josedaparte/TESIS/doumentos_PROPIOS/Diseño_PWM/Imagenes_documento/amp-error-coneccion.PNG

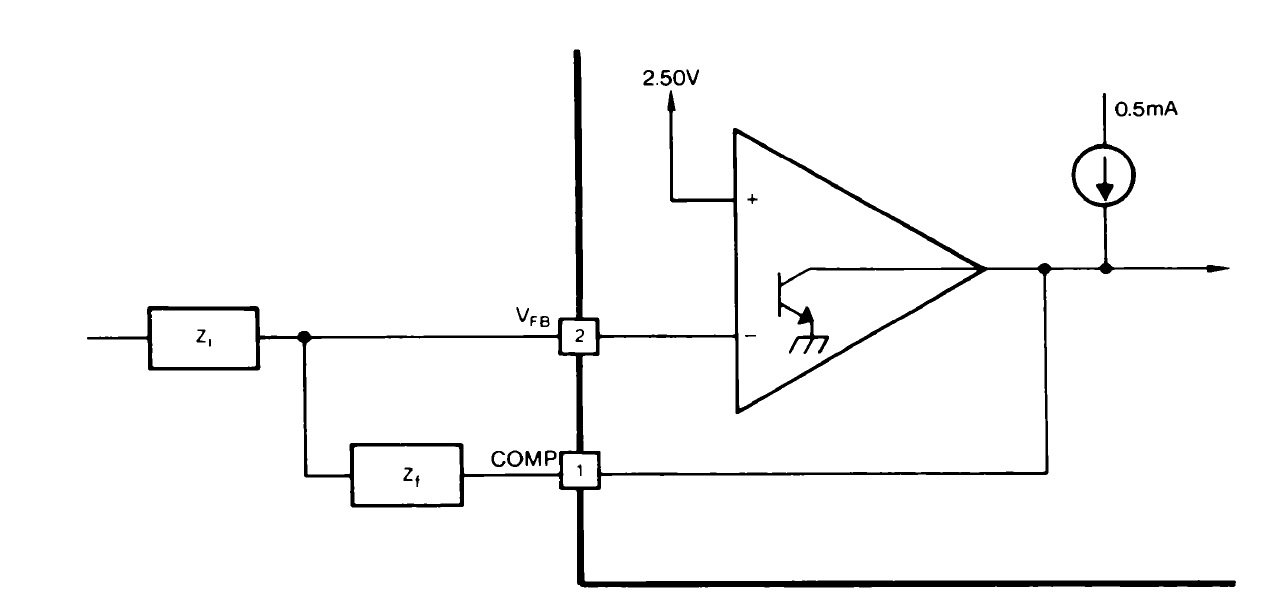
doumentos_PROPIOS/Diseño_PWM/Imagenes_documento/amp-error-coneccion.PNG
