josedaparte/TESIS/doumentos_PROPIOS/Diseño_PWM/Imagenes_documento/Amplificador-error.PNG

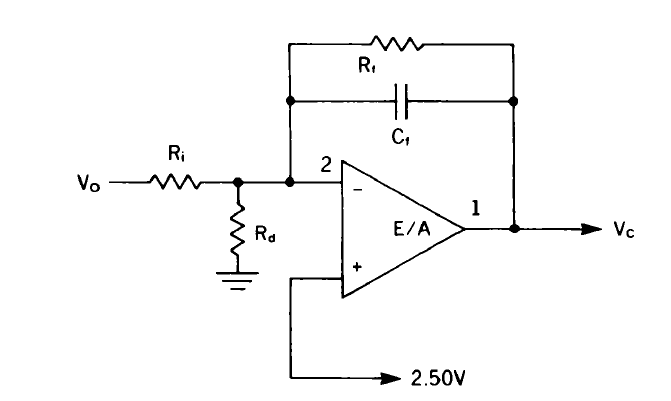
doumentos_PROPIOS/Diseño_PWM/Imagenes_documento/Amplificador-error.PNG
