josedaparte/TESIS/doumentos_PROPIOS/Diseño_PWM/Imagenes_documento/circuito_oscilador.PNG

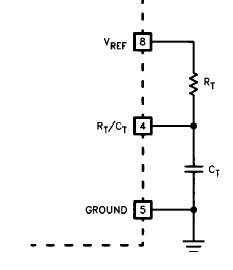
doumentos_PROPIOS/Diseño_PWM/Imagenes_documento/circuito_oscilador.PNG
