josedaparte/TESIS/doumentos_PROPIOS/Diseño_PWM/Imagenes_documento/Esquema_UC3842.PNG

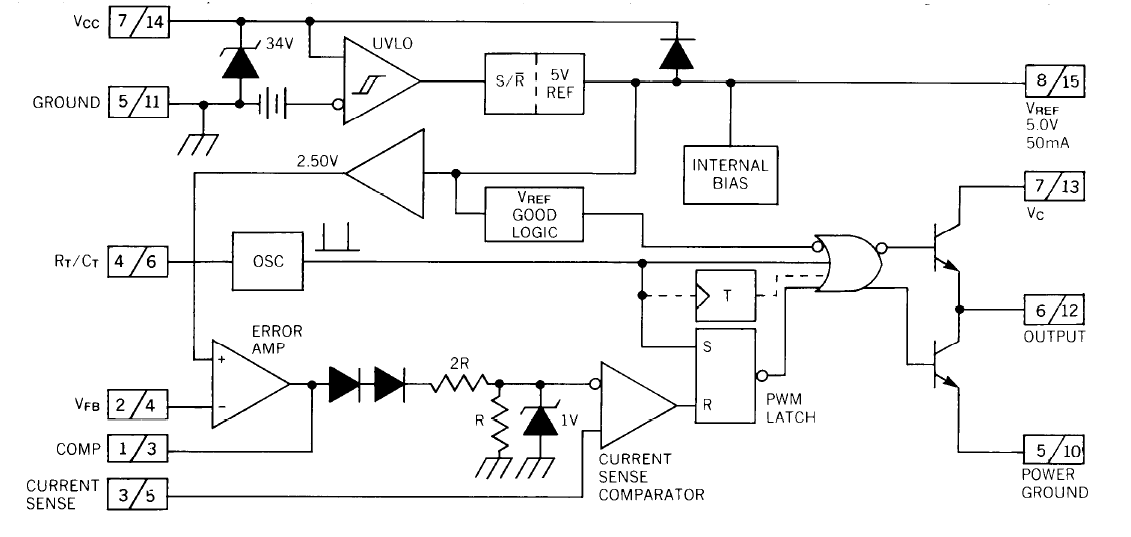
doumentos_PROPIOS/Diseño_PWM/Imagenes_documento/Esquema_UC3842.PNG
