josedaparte/TESIS/doumentos_PROPIOS/Diseño_PWM/Imagenes_documento/IC_selection.PNG

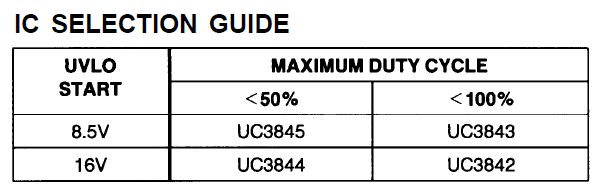
doumentos_PROPIOS/Diseño_PWM/Imagenes_documento/IC_selection.PNG
