josedaparte/TESIS/Scripts_MATLAB/Componentes a utilizar.txt

Mosfet 
Ipk = 3.01A
Irms = 1.8A	--> MOSFETFQP5N60C_600V_4A5

Diodo salida
IPk = 2.72A
Iavg = 1.2A
Vinv = 515V	-->

Rsensora corriente
Rcs=0.33Ohm
Irms = 1.8A				

Cin = 138uF	--> Valor cercano

Cout= 51uF	--> Valor cercano	

Lp=940uH

transistor regulador para el opto y tl 2n5400
