josedaparte/TESIS/Documentos utiles/Diseño_por_texas_100V_1200mA.pdf

## WEBENCH ® Design Report

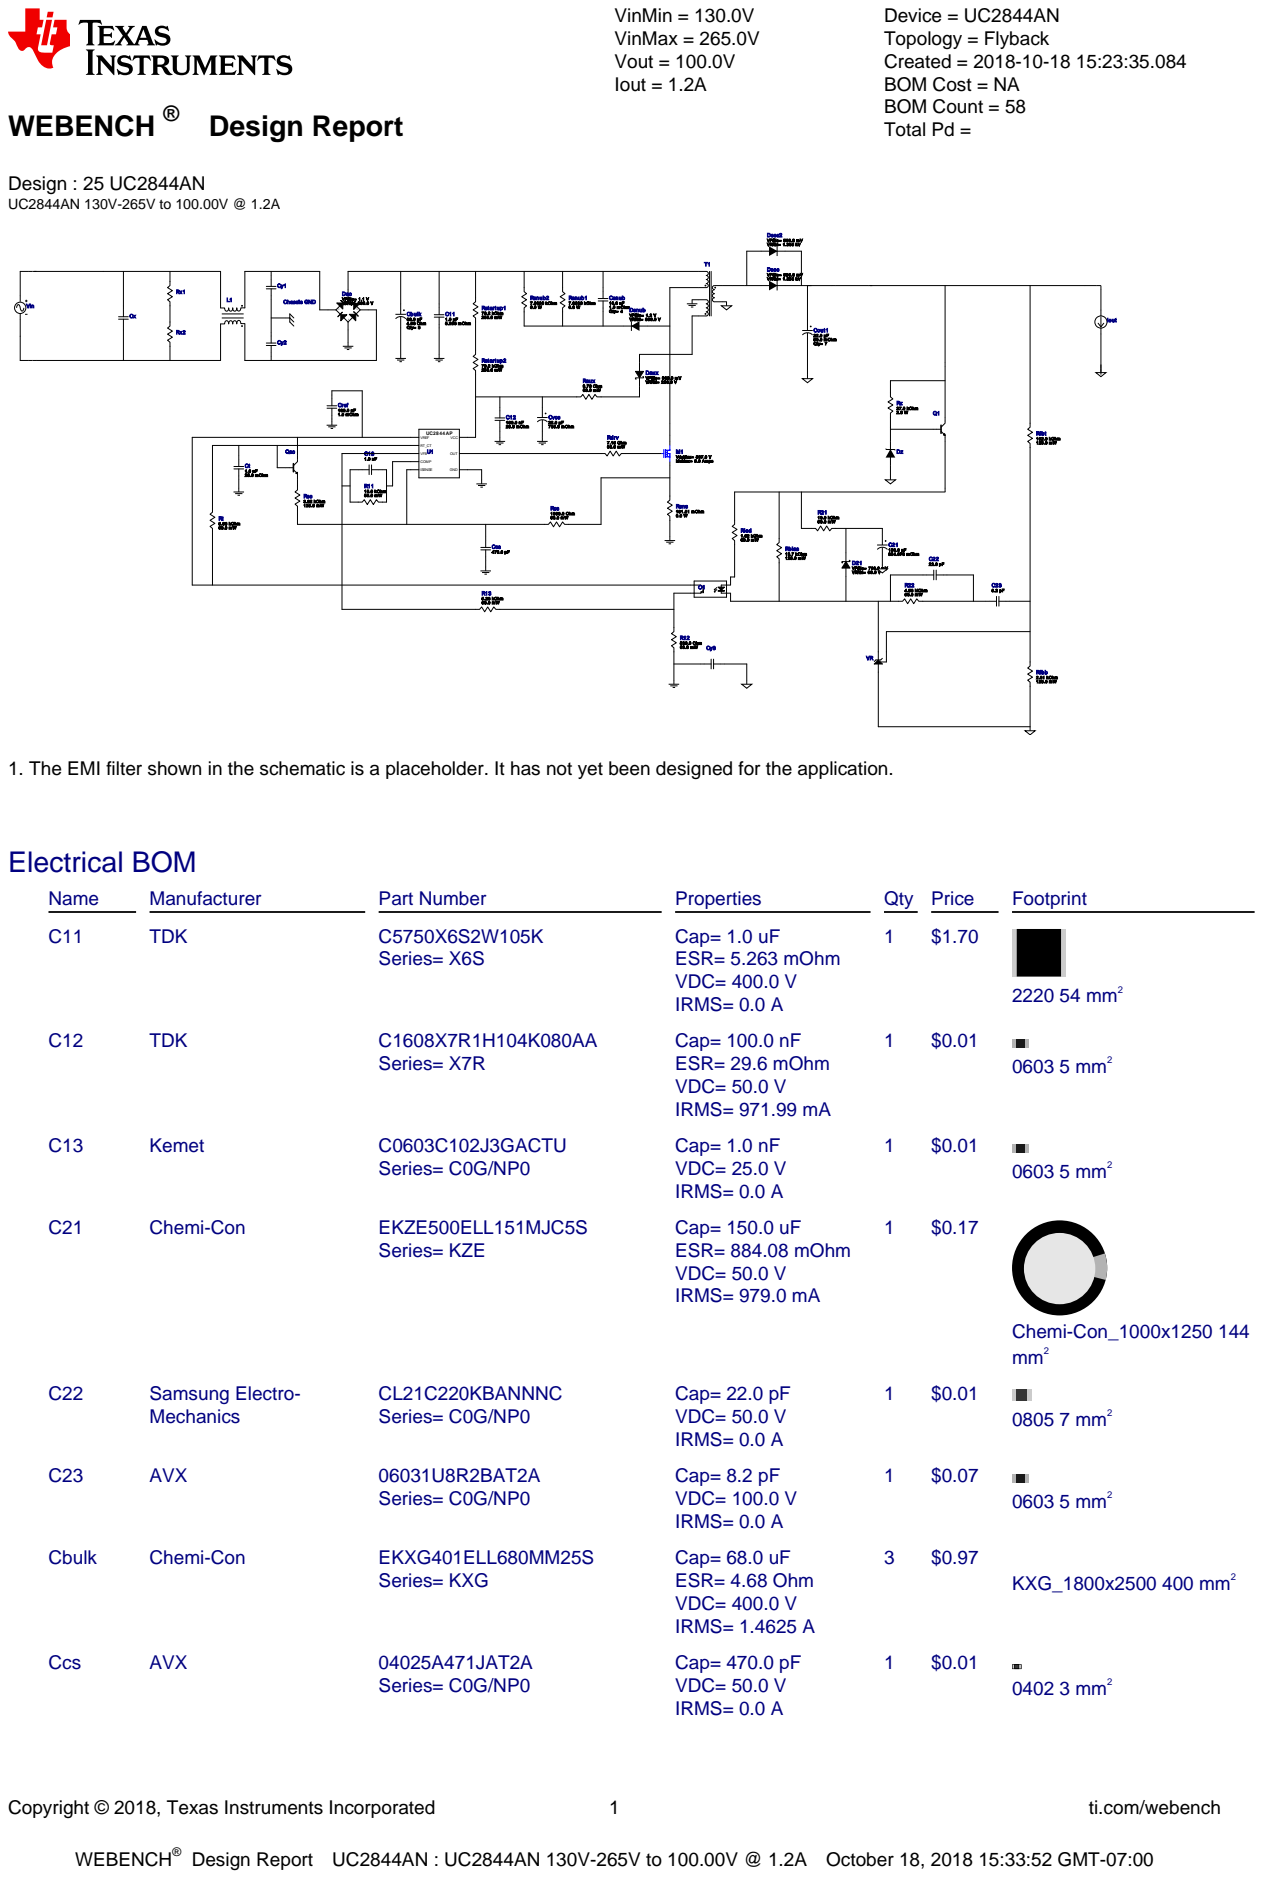
[picture p31: page 1]

Dsec VF@Io= 500.0 mV

Daux VF@Io= 900.0 mV

1. The EMI filter shown in the schematic is a placeholder. It has not yet been designed for the application.

Design Report UC2844AN : UC2844AN 130V-265V to 100.00V @ 1.2A October 18, 2018 15:33:52 GMT-07:00

Design

Copyright © 2018, Texas Instruments Incorporated | 2 | ti.com/webench
Name | Manufacturer | Part Number | Properties | Qty Price | Footprint
Cout1 | Rubycon | 400PK22MEFC12_5X20 (http://www.rubycon.co.jp/en/catalog/e%5Fpdfs/aluminum/e%5Fpk.pdf) Series= PK | Cap= 22.0 uF ESR= 50.0 mOhm VDC= 400.0 V IRMS= 200.0 mA
7 | $0.40

CAPPR7 144 mm²
Cref | MuRata | GRM155R61C104KA88D (http://search.murata.co.jp/Ceramy/PnsearchViewAction.do) Series= X5R

Cap= 100.0 nF
ESR= 1.0 mOhm
VDC= 16.0 V
IRMS= 0.0 A

1 $0.01
0402 3 mm²
Csnub | MuRata | GRM21BR72E103KW03L (http://search.murata.co.jp/Ceramy/PnsearchViewAction.do) Series= X7R

Cap= 10.0 nF
ESR= 1.0 mOhm
VDC= 250.0 V
IRMS= 0.0 A

4 $0.04
0805 7 mm²
Ct | Kemet | C0805C102J1GACTU (http://capacitoredge.kemet.com/capedge2/DataSheet/Datasheet%2DC0805C102J1GACTU.pdf?pn%3DC0805C102J1GACTU) Series= C0G/NP0

Cap= 1.0 nF
ESR= 25.0 mOhm
VDC= 100.0 V
IRMS= 1.71 A

1 $0.10
0805 7 mm²
Cvcc | Nichicon | UUD1V220MCL1GS (http://products.nichicon.co.jp/en/pdf/XJA043/e%2Dud.pdf) Series= uD | Cap= 22.0 uF ESR= 760.0 mOhm VDC= 35.0 V IRMS= 150.0 mA
1 | $0.10

SM_RADIAL_5MM 58 mm²

D21 | Fairchild Semiconductor SS26FL | VF@Io= 700.0 mV
| | | VRRM= 60.0 V
1 | $0.10
SOD-123F 12 mm²
Dac | Diodes Inc. | DF1506S-T (http://www.diodes.com/datasheets/ds17002.pdf) | VF@Io= 1.1 V VRRM= 600.0 V
1 | $0.23

DF-S 99 mm²
Daux | SMC Diode Solutions | SK220ATR (http://www.smc%2Ddiodes.com/propdf/SK220A%20N0942%20REV.A.pdf) | VF@Io= 900.0 mV VRRM= 200.0 V | 1 | $0.04

SMA 37 mm²
Dsec | CUSTOM | CUSTOM | VF@Io= 500.0 mV VRRM= 1.355 kV | 1 | NA
CUSTOM 0 mm²
Dsec2 | CUSTOM | CUSTOM | VF@Io= 500.0 mV VRRM= 1.355 kV | 1 | NA
CUSTOM 0 mm²
Dsnub | Microsemi | UFS180JE3/TR13 | VF@Io= 1.2 V VRRM= 800.0 V | 1 | $0.71

DO-214BA 42 mm²
Dz | Diodes Inc. | MMSZ5250B-7-F (http://www.diodes.com/datasheets/ds18010.pdf) | Zener | 1 | $0.04
SOD-123 13 mm²
M1 | NA | IdealFET | VdsMax= 597.0 V IdsMax= 5.0 Amps | 1 | NA
NA 0 mm²
O1 | Fairchild Semiconductor FOD817A | Optocoupler | 1 | $0.13

DIP-4 71 mm²
Q1 | Nexperia | MMBTA42 (http://www.nxp.com/documents/data%5Fsheet/MMBTA42.pdf) | Bipolar Transistor | 1 | $0.05

SOT-23 14 mm²
Qsc | STMicroelectronics | 2N2222A (http://www.st.com/web/en/resource/technical/document/datasheet/CD00003223.pdf) | Bipolar Transistor | 1 | $1.02

TO-18 57 mm²
R11 | Yageo | RC0201FR-0710KL (http://www.yageo.com/exep/pages/download/literatures/PYu%2DR%5FMarking%5F2.pdf) Series= ? | Res= 10.0 kOhm Power= 50.0 mW Tolerance= 1.0% | 1 | $0.01
0201 2 mm²
R12 | Vishay-Dale | CRCW0402536RFKED (http://www.vishay.com/docs/20035/dcrcwe3.pdf) Series= CRCW..e3 | Res= 536.0 Ohm Power= 63.0 mW Tolerance= 1.0% | 1 | $0.01
0402 3 mm²
R13 | Vishay-Dale | CRCW04025K23FKED (http://www.vishay.com/docs/20035/dcrcwe3.pdf) Series= CRCW..e3 | Res= 5.23 kOhm Power= 63.0 mW Tolerance= 1.0% | 1 | $0.01
0402 3 mm²

Copyright © 2018, Texas Instruments Incorporated | 3 | ti.com/webench
Name | Manufacturer | Part Number | Properties | Qty Price | Footprint
R21 | Yageo | RC0201FR-0710KL (http://www.yageo.com/exep/pages/download/literatures/PYu%2DR%5FMarking%5F2.pdf) Series= ? | Res= 10.0 kOhm Power= 50.0 mW Tolerance= 1.0%
1 | $0.01
| | | | | 0201 2 mm²
R22 | Vishay-Dale | CRCW04024M53FKED (http://www.vishay.com/docs/20035/dcrcwe3.pdf) Series= CRCW..e3 | Res= 4.53 MOhm Power= 63.0 mW Tolerance= 1.0%
1 | $0.01
| | | | | 0402 3 mm²
Raux | Vishay-Dale | CRCW04029R76FKED (http://www.vishay.com/docs/20035/dcrcwe3.pdf) Series= CRCW..e3 | Res= 9.76 Ohm Power= 63.0 mW Tolerance= 1.0%
1 | $0.01
| | | | | 0402 3 mm²
Rbias | Panasonic | ERJ-6ENF1372V Series= ERJ-6E | Res= 13.7 kOhm Power= 125.0 mW Tolerance= 1.0%
1 | $0.01
| | | | | 0805 7 mm²
Rcs | Vishay-Dale | CRCW04021K00FKED (http://www.vishay.com/docs/20035/dcrcwe3.pdf) Series= CRCW..e3 | Res= 1000.0 Ohm Power= 63.0 mW Tolerance= 1.0%
1 | $0.01
| | | | | 0402 3 mm²
Rdrv | Vishay-Dale | CRCW04027R15FKED (http://www.vishay.com/docs/20035/dcrcwe3.pdf) Series= CRCW..e3 | Res= 7.15 Ohm Power= 63.0 mW Tolerance= 1.0%
1 | $0.01
| | | | | 0402 3 mm²
Rfbb | Panasonic | ERJ-6ENF2611V Series= ERJ-6E | Res= 2.61 kOhm Power= 125.0 mW Tolerance= 1.0%
1 | $0.01
| | | | | 0805 7 mm²
Rfbt | Vishay-Dale | CRCW0805102KFKEA (http://www.vishay.com/docs/20035/dcrcwe3.pdf) Series= CRCW..e3 | Res= 102.0 kOhm Power= 125.0 mW Tolerance= 1.0%
1 | $0.01
| | | | | 0805 7 mm²
Rled | Vishay-Dale | CRCW04021K62FKED (http://www.vishay.com/docs/20035/dcrcwe3.pdf) Series= CRCW..e3 | Res= 1.62 kOhm Power= 63.0 mW Tolerance= 1.0%
1 | $0.01
| | | | | 0402 3 mm²
Rsc | Vishay-Dale | CRCW08053K92FKEA (http://www.vishay.com/docs/20035/dcrcwe3.pdf) Series= CRCW..e3 | Res= 3.92 kOhm Power= 125.0 mW Tolerance= 1.0%
1 | $0.01
| | | | | 0805 7 mm²
Rsns | CUSTOM | CUSTOM Series= ? | Res= 181.51 mOhm Power= 0.0 W Tolerance= 0.0%
1 | NA
| | | | | CUSTOM 0 mm²
Rsnub1 | CUSTOM | CUSTOM Series= ? | Res= 7.0636 kOhm Power= 0.0 W Tolerance= 0.0%
1 | NA
| | | | | CUSTOM 0 mm²
Rsnub2 | CUSTOM | CUSTOM Series= ? | Res= 7.0636 kOhm Power= 0.0 W Tolerance= 0.0%
1 | NA
| | | | | CUSTOM 0 mm²
Rstartup1 Vishay-Dale | CRCW120673K2FKEA (http://www.vishay.com/docs/20035/dcrcwe3.pdf)
| | Series= CRCW..e3 | Res= 73.2 kOhm Power= 250.0 mW Tolerance= 1.0%
1 | $0.01
| | | | | 1206 11 mm²
Rstartup2 Vishay-Dale | CRCW120673K2FKEA (http://www.vishay.com/docs/20035/dcrcwe3.pdf)
| | Series= CRCW..e3 | Res= 73.2 kOhm Power= 250.0 mW Tolerance= 1.0%
1 | $0.01
| | | | | 1206 11 mm²
Rt | Vishay-Dale | CRCW04028K66FKED (http://www.vishay.com/docs/20035/dcrcwe3.pdf) Series= CRCW..e3 | Res= 8.66 kOhm Power= 63.0 mW Tolerance= 1.0%
1 | $0.01
| | | | | 0402 3 mm²
Rz | Stackpole Electronics Inc RSMF2JT27K0 (http://www.seielect.com/Catalog/SEI%2DRSF%5FRSMF.pdf)
| | Series= ? | Res= 27.0 kOhm Power= 2.0 W Tolerance= 5.0%
1 | $0.02
| | | | | RSMF2 148 mm²
T1 | Core=TDK , CoilFormer=TDK | Core=B66423G0000X197 , CoilFormer=B66424W1012D001 | Lp= 203.0 µH Turns Ratio(Nas)= 9:58 Turns Ratio(Nps)= 49:58 Npri= 49.0 Naux= 9.0 Nsec= 58.0
1 | $1.25
| | | | | TDK_B66305 930 mm²

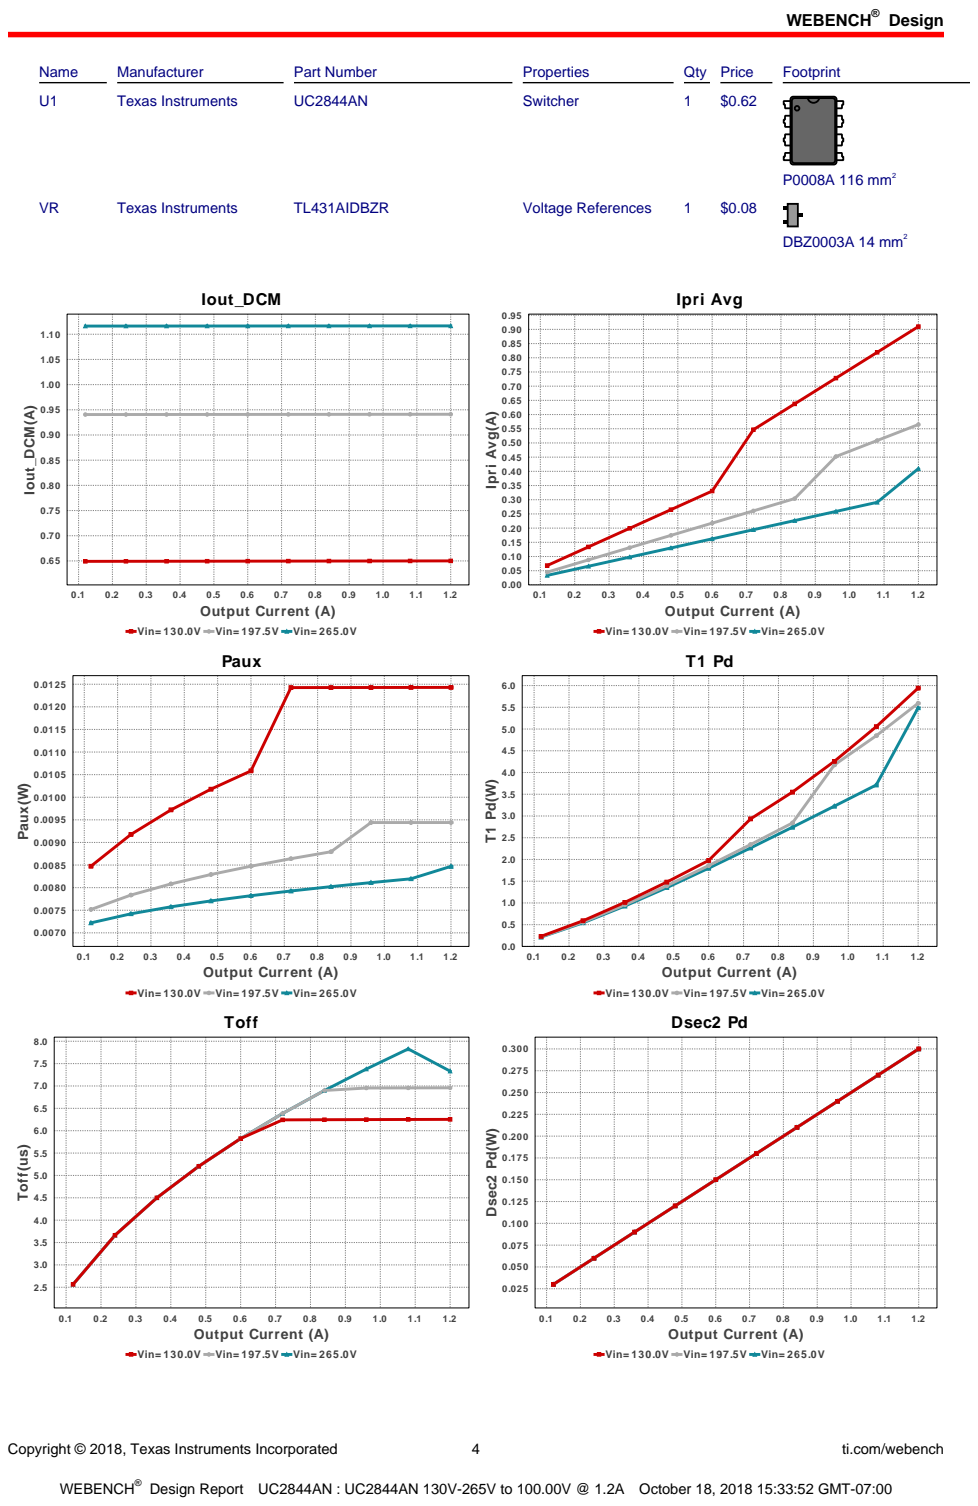
[picture p32: page 4]
Copyright © 2018, Texas Instruments Incorporated; ti.com/webench; Name; Manufacturer; Part Number; Properties; Qty Price; Footprint; Texas Instruments; Switcher; P0008A 116 mm²; TL431AIDBZR; Voltage References; DBZ0003A 14 mm²; Iout_DCM; 1.2 Output Current (A); Iout_DCM(A); Ipri Avg; Ipri Avg(A); Paux; Paux(W); Toff; Toff(us); Dsec2 Pd; Dsec2 Pd(W)

Vin= 130.0V Vin= 197.5V Vin= 265.0V

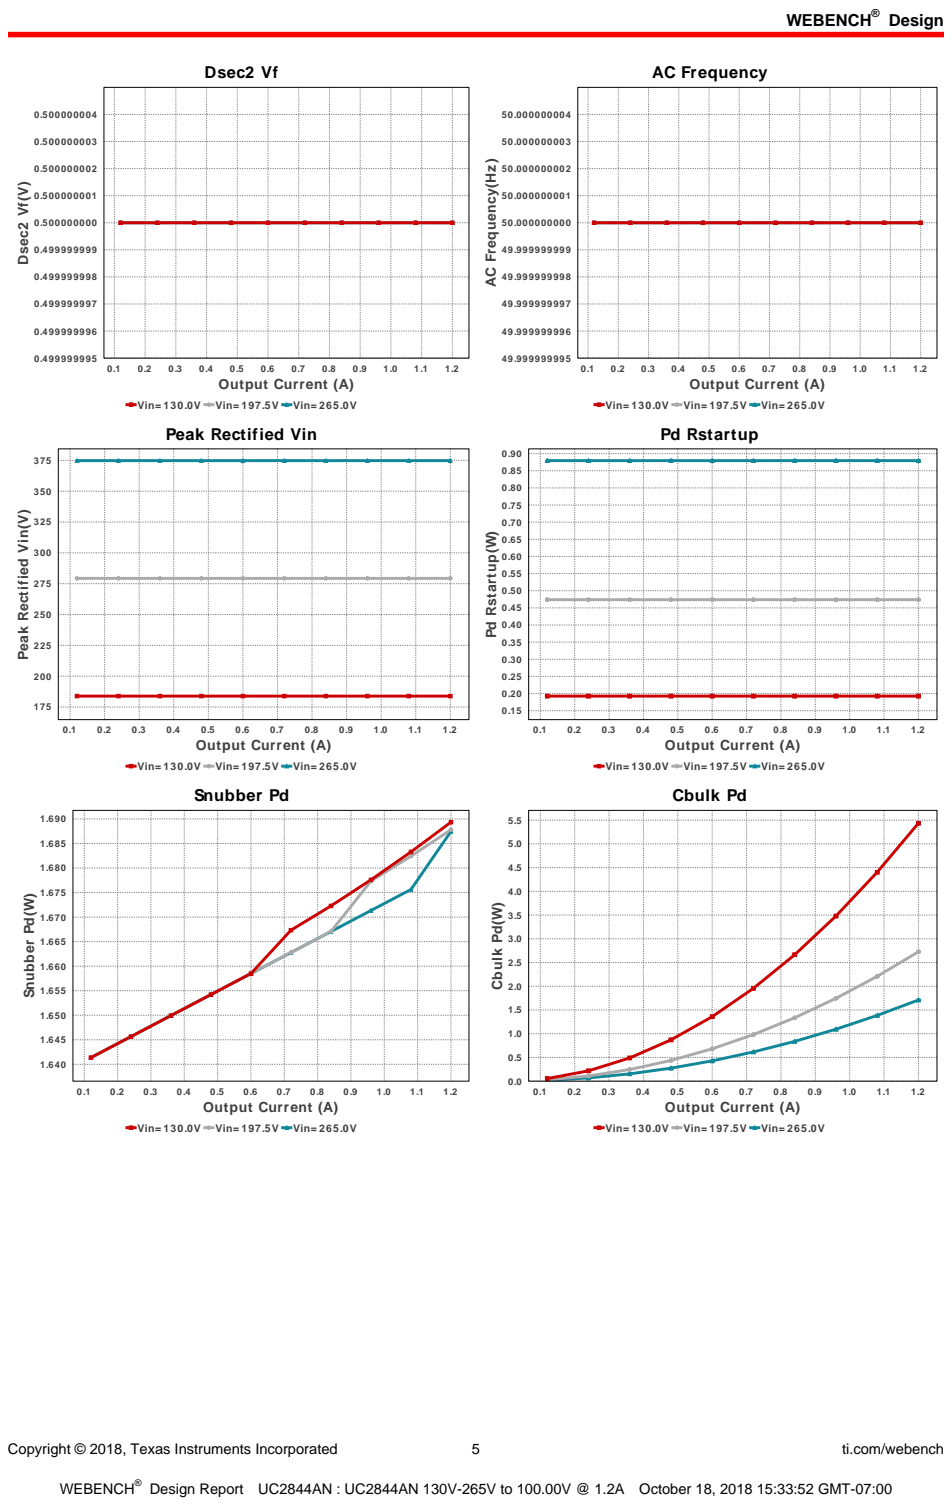
[picture p33: page 5]
Copyright © 2018, Texas Instruments Incorporated; ti.com/webench; Dsec2 Vf; 1.2 Output Current (A); Dsec2 Vf(V); AC Frequency; Pd Rstartup(W); Snubber Pd(W); Cbulk Pd; Cbulk Pd(W)

AC Frequency(Hz)

Vin= 130.0V Vin= 197.5V Vin= 265.0V
Peak Rectified Vin

Pd Rstartup

Peak Rectified Vin(V)

Snubber Pd

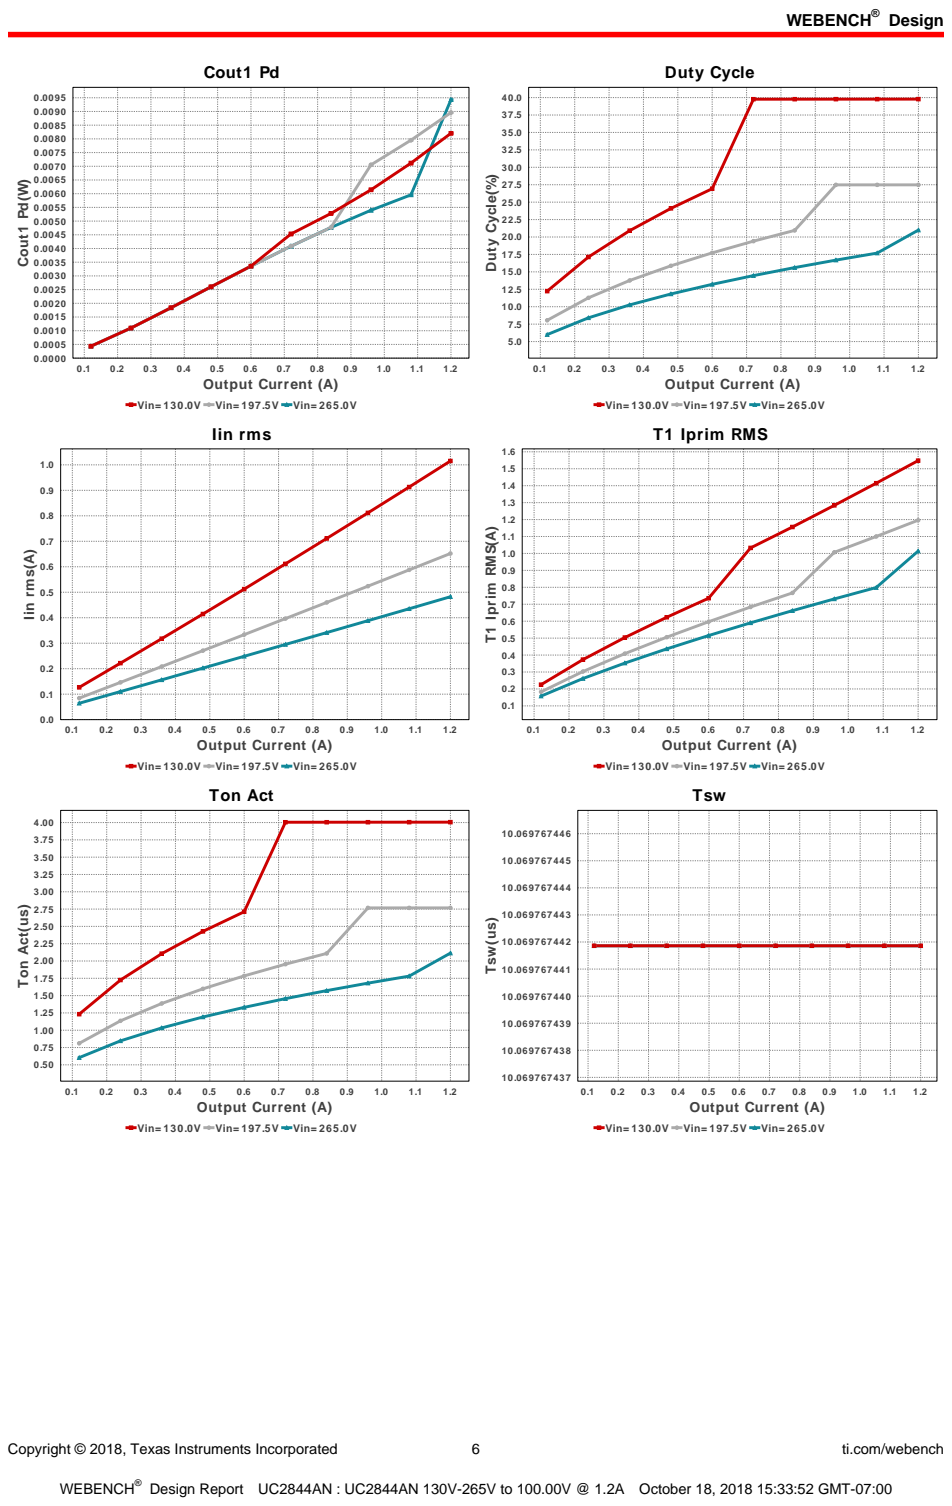
[picture p34: page 6]
Copyright © 2018, Texas Instruments Incorporated; ti.com/webench; Cout1 Pd; 1.2 Output Current (A); Cout1 Pd(W); Duty Cycle; Duty Cycle(%); Iin rms; Iin rms(A); T1 Iprim RMS(A); Ton Act; Tsw; Tsw(us)

Vin= 130.0V Vin= 197.5V Vin= 265.0V

T1 Iprim RMS

Ton Act(us)

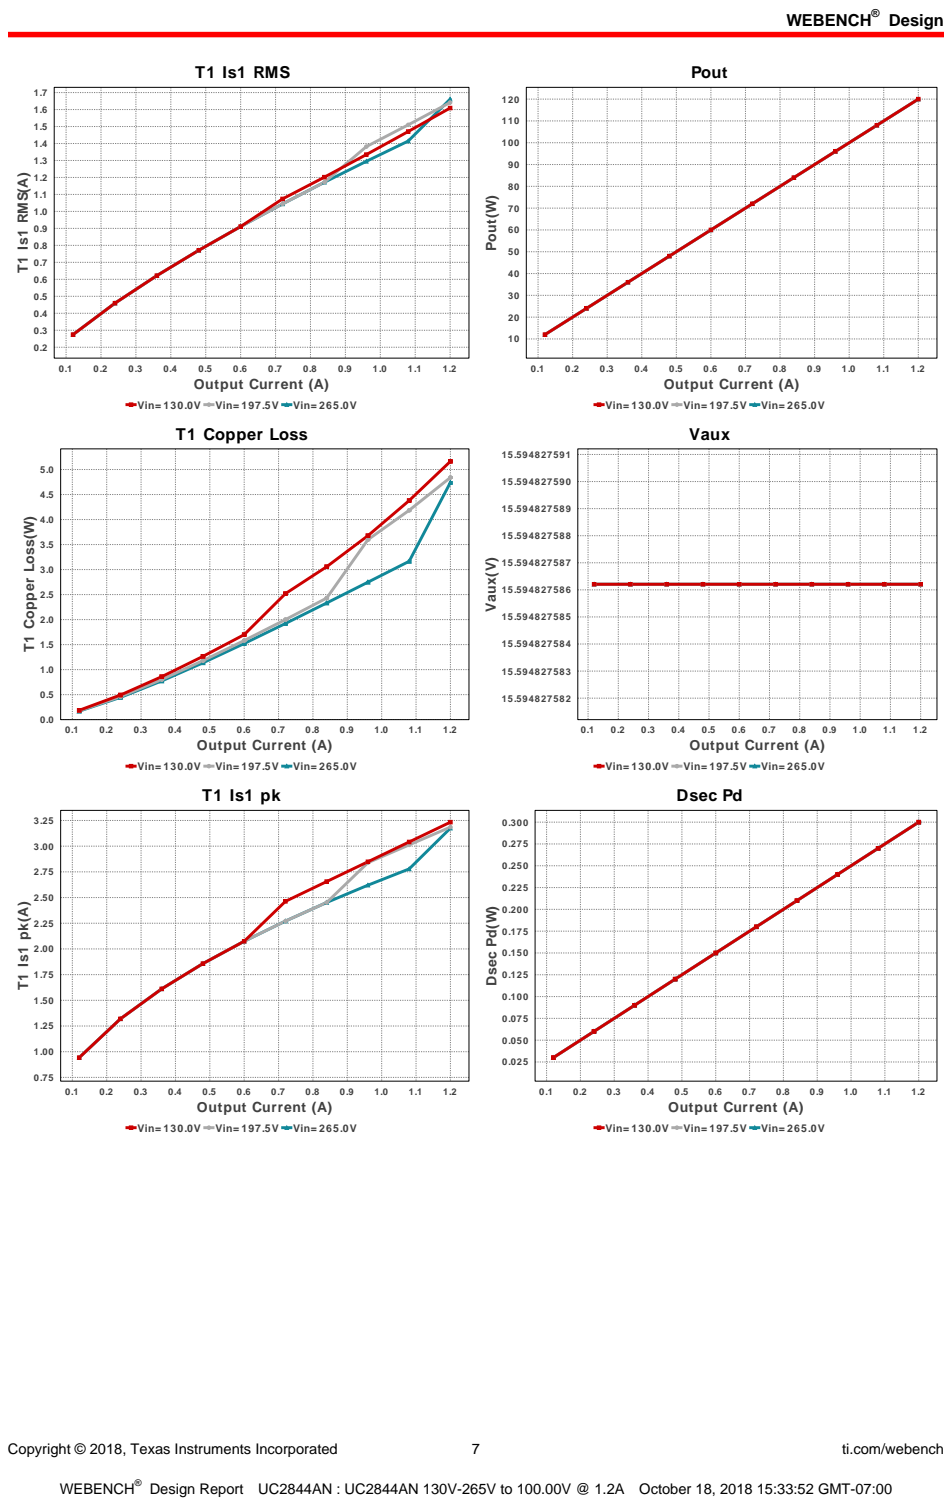
[picture p35: page 7]
Copyright © 2018, Texas Instruments Incorporated; ti.com/webench; T1 Is1 RMS; 1.2 Output Current (A); T1 Is1 RMS(A); Pout; Pout(W); T1 Copper Loss(W); Vaux; Vaux(V); Dsec Pd; Dsec Pd(W)

Vin= 130.0V Vin= 197.5V Vin= 265.0V
T1 Copper Loss

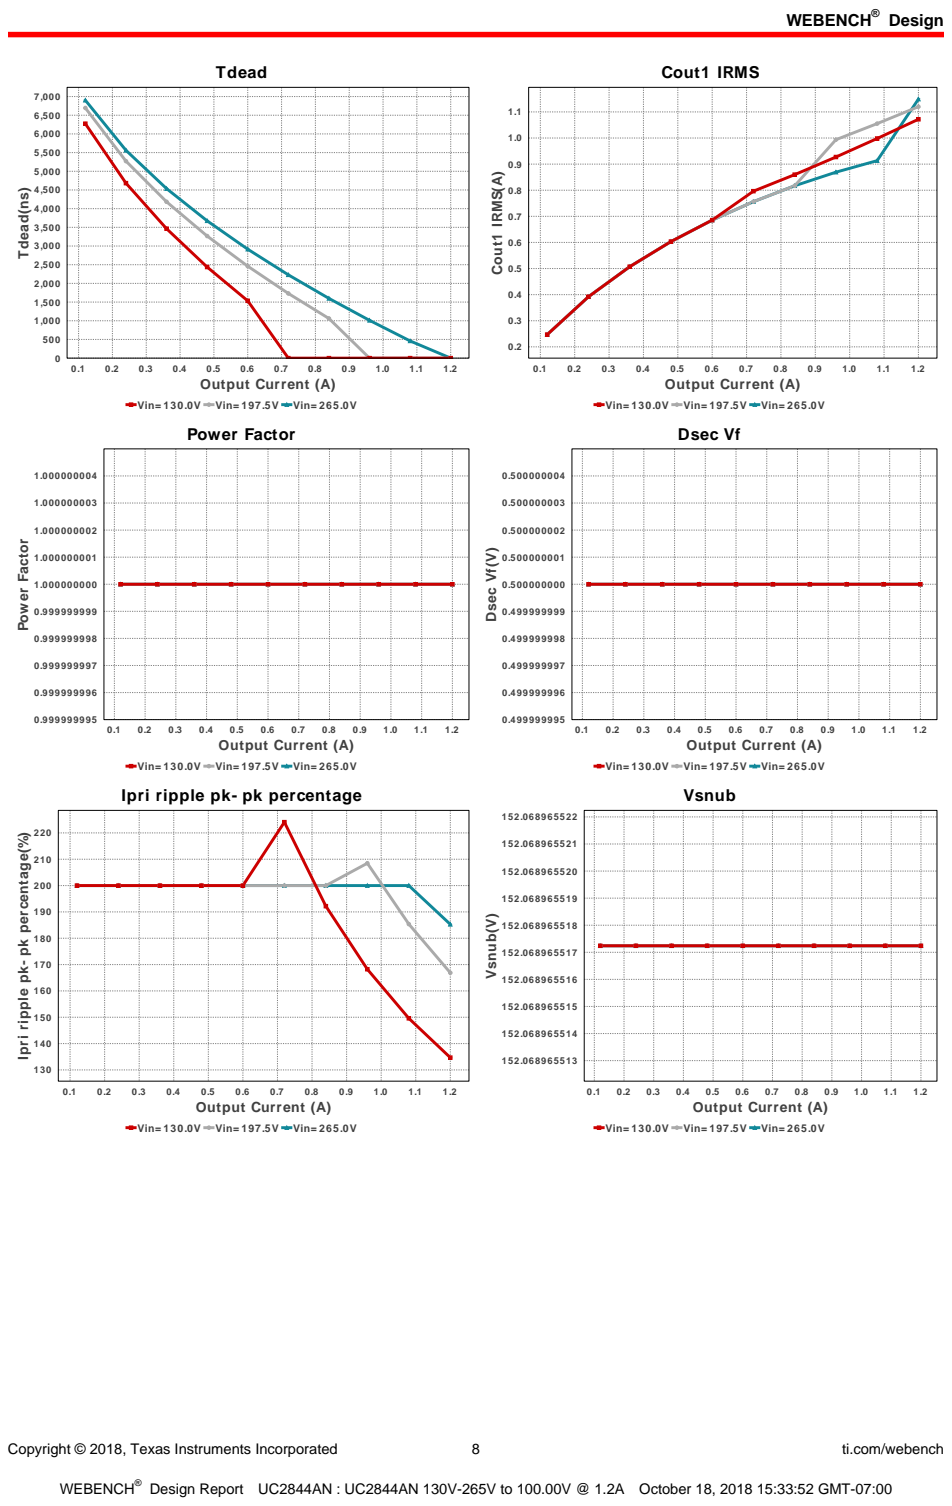
[picture p36: page 8]
Copyright © 2018, Texas Instruments Incorporated; ti.com/webench; Tdead; 1.2 Output Current (A); Tdead(ns); Cout1 IRMS; Cout1 IRMS(A); Power Factor; Dsec Vf; Dsec Vf(V); Vsnub; Vsnub(V)

Vin= 130.0V Vin= 197.5V Vin= 265.0V
Power Factor

Ipri ripple pk- pk percentage

Ipri ripple pk- pk percentage(%)

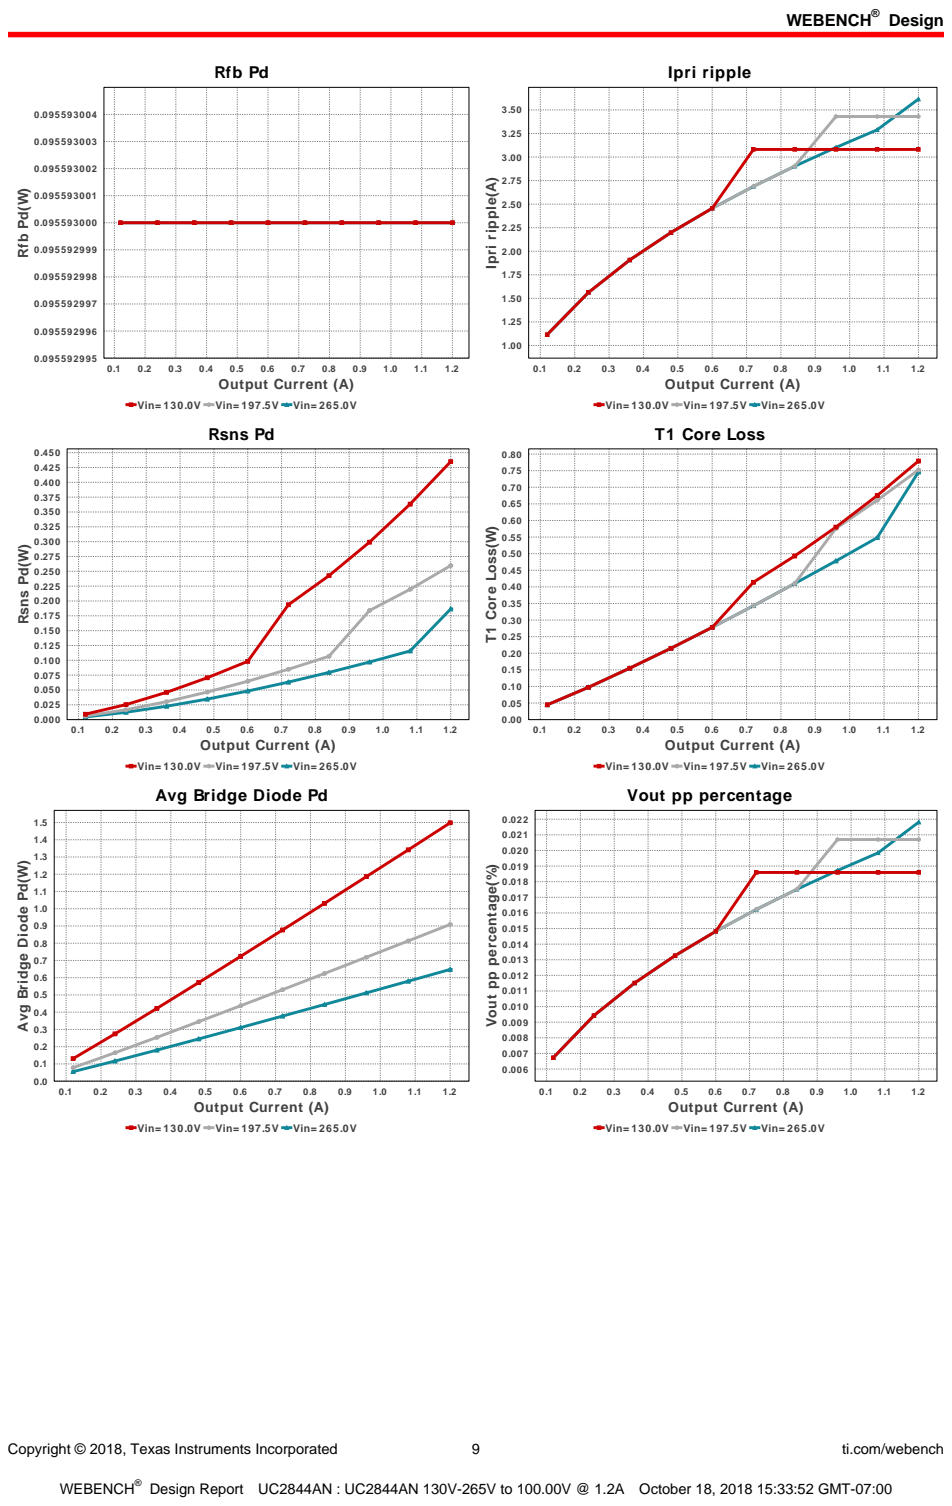
[picture p37: page 9]
Copyright © 2018, Texas Instruments Incorporated; ti.com/webench; Rfb Pd; 1.2 Output Current (A); Rfb Pd(W); Ipri ripple; Ipri ripple(A); Rsns Pd; Rsns Pd(W); T1 Core Loss(W)

Vin= 130.0V Vin= 197.5V Vin= 265.0V

T1 Core Loss

Avg Bridge Diode Pd

Vout pp percentage

Avg Bridge Diode Pd(W)

Vout pp percentage(%)

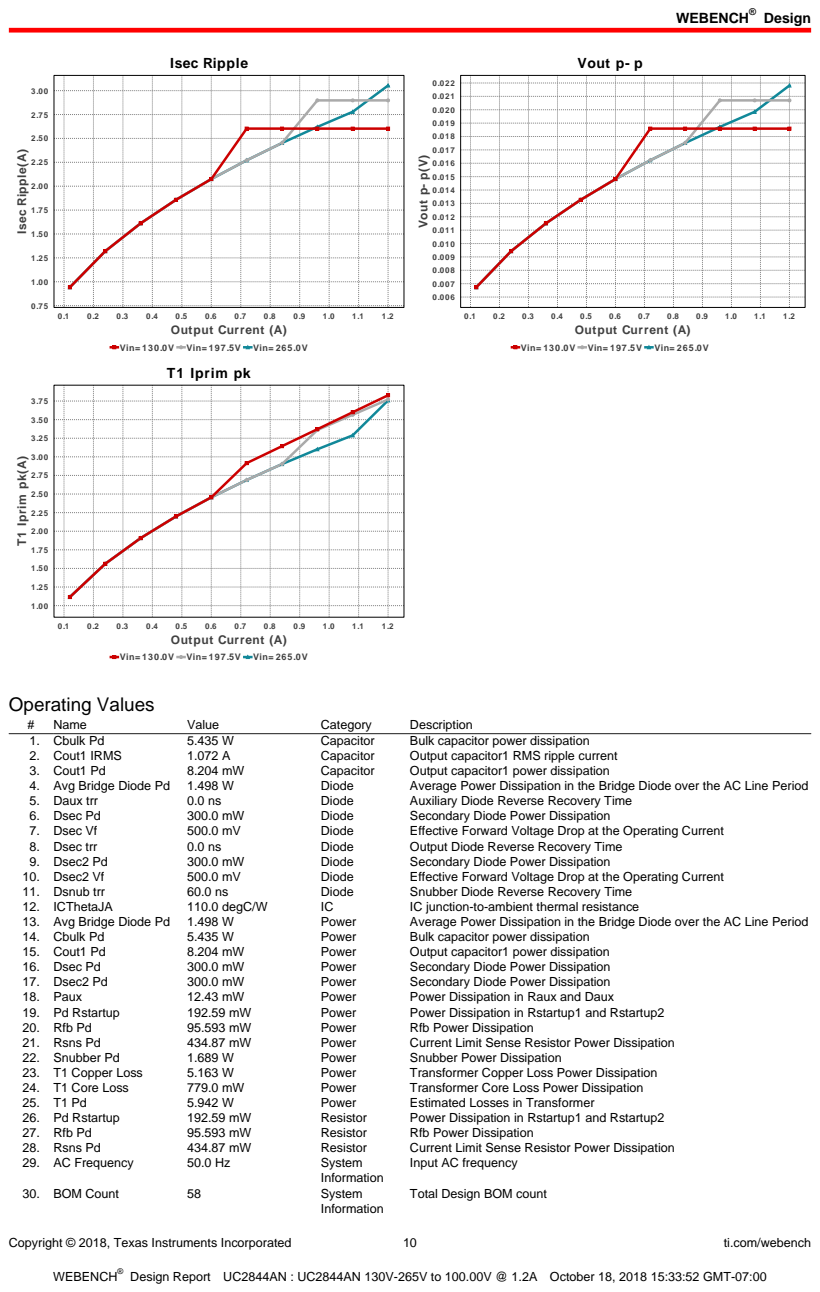
[picture p38: page 10]
Copyright © 2018, Texas Instruments Incorporated; ti.com/webench; Isec Ripple; 1.2 Output Current (A); Isec Ripple(A); Vout p- p; Vout p- p(V); T1 Iprim pk(A); Operating Values; Name; Value; Category; Description; 1. Cbulk Pd; Capacitor; Bulk capacitor power dissipation; 2. Cout1 IRMS; Output capacitor1 RMS ripple current; 3. Cout1 Pd; Output capacitor1 power dissipation; 4. Avg Bridge Diode Pd 1.498 W; Diode; Average Power Dissipation in the Bridge Diode over the AC Line Period; 5. Daux trr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

Vin= 130.0V Vin= 197.5V Vin= 265.0V
T1 Iprim pk

Input AC frequency

Total Design BOM count

Copyright © 2018, Texas Instruments Incorporated | 11 | ti.com/webench
# | Name | Value | Category | Description

31. Duty Cycle | 39.781 % | System
| | | Information | Duty cycle
32. FootPrint | 4.305 k mm² | System
| | | Information | Total Foot Print Area of BOM components
33. Frequency | 99.307 kHz | System
| | | Information | Switching frequency
34. Iin rms | 1.015 A | System
| | | Information | RMS Input Current
35. Iout | 1.2 A | System
| | | Information | Iout operating point
36. Iout_DCM | 650.049 mA | System
| | | Information | Approximate Current below which DCM mode of operation will begin
37. Mode | CCM | System
| | | Information | Conduction Mode
38. Peak Rectified Vin | 183.846 V | System
| | | Information | Peak voltage seen at rectified input
39. Pout | 120.0 W | System
| | | Information | Total output power
40. Power Factor | 1.0 | System
| | | Information | Assumed Power Factor for the Application
41. Tdead | 0.0 ns | System
| | | Information | Approximate Dead Time of the Regulator
42. Toff | 6.253 us | System
| | | Information | Approximate Converter Off Time
43. Ton Act | 4.006 us | System
| | | Information | Approximate Converter On Time
44. Total BOM | NA | System
| | | Information | Total BOM Cost
45. Tsw | 10.07 us | System
| | | Information | Switching Time Period
46. Vin_RMS | 130.0 V | System
| | | Information | Vin operating point
47. Vout | 100.0 V | System
| | | Information | Operational Output Voltage
48. Vout Actual | 100.001 V | System
| | | Information | Vout Actual calculated based on selected voltage divider resistors
49. Vout Tolerance | 2.297 % | System
| | | Information | Vout Tolerance based on IC Tolerance (no load) and voltage divider resistors if applicable
50. Vout p-p | 18.589 mV | System
| | | Information | Peak-to-peak output ripple voltage
51. Vout pp percentage | 18.589 m% | System
| | | Information | Output Voltage ripple percentage
52. Vsnub | 152.069 V | System
| | | Information | Voltage Across the Snubber
53. Ipri Avg | 909.932 mA | Transformer | Average Current in Primary Winding over the complete Switching
| | | | Period
54. Ipri ripple | 3.08 A | Transformer | Ripple Current in the Primary Winding
55. Ipri ripple pk-pk
| percentage | 134.672 % | Transformer | Primary Current pk-pk ripple percentage(of Ipri avg during ton only)
56. Isec Ripple | 2.602 A | Transformer | Ripple Current in the Secondary Winding
57. Paux | 12.43 mW | Transformer | Power Dissipation in Raux and Daux
58. T1 Copper Loss | 5.095 W | Transformer | Transformer Copper Loss Power Dissipation
59. T1 Core Loss | 772.0 mW | Transformer | Transformer Core Loss Power Dissipation
60. T1 Iprim RMS | 1.548 A | Transformer | Transformer Primary RMS Current
61. T1 Iprim pk | 3.828 A | Transformer | Transformer Primary Peak Current
62. T1 Is1 RMS | 1.609 A | Transformer | Transformer Secondary1 RMS Current
63. T1 Is1 pk | 3.234 A | Transformer | Transformer Secondary1 Peak Current
64. T1 Pd | 5.867 W | Transformer | Estimated Losses in Transformer
65. Vaux | 15.595 V | Transformer | Auxiliary Voltage

## Design Inputs

Name | Value | Description
Iout | 1.2 | Maximum Output Current
VinMax | 265.0 | Maximum input voltage
VinMin | 130.0 | Minimum input voltage
Vout | 100.0 | Output Voltage
acFrequency | 50.0 | AC Frequency
| base_pn | | UC2844A | Base Product Number
source | AC | Input Source Type
Ta | 30.0 | Ambient temperature


Copyright © 2018, Texas Instruments Incorporated | 12 | ti.com/webench

## Assembly

## Component Testing

Some published data on components in datasheets such as Capacitor ESR and Inductor DC resistance is based on conservative values that will guarantee that the components always exceed the specification. For design purposes it is usually better to work with typical values. Since this data is not always available it is a good practice to measure the Capacitance and ESR values of Cin and Cout, and the inductance and DC resistance of L1 before assembly of the board. Any large discrepancies in values should be electrically simulated in WEBENCH to check for instabilities and thermally simulated in WebTHERM to make sure critical temperatures are not exceeded.

## Soldering Component to Board

If board assembly is done in house it is best to tack down one terminal of a component on the board then solder the other terminal. For surface mount parts with large tabs, such as the DPAK, the tab on the back of the package should be pre-tinned with solder, then tacked into place by one of the pins. To solder the tab town to the board place the iron down on the board while resting against the tab, heating both surfaces simultaneously. Apply light pressure to the top of the plastic case until the solder flows around the part and the part is flush with the PCB. If the solder is not flowing around the board you may need a higher wattage iron (generally 25W to 30W is enough).

## Initial Startup of Circuit

It is best to initially power up the board by setting the input supply voltage to the lowest operating input voltage 130.0V and set the input supply's current limit to zero. With the input supply off connect up the input supply to Vin and GND. Connect a digital volt meter and a load if needed to set the minimum Iout of the design from Vout and GND. Turn on the input supply and slowly turn up the current limit on the input supply. If the voltage starts to rise on the input supply continue increasing the input supply current limit while watching the output voltage. If the current increases on the input supply, but the voltage remains near zero, then there may be a short or a component misplaced on the board. Power down the board and visually inspect for solder bridges and recheck the diode and capacitor polarities. Once the power supply circuit is operational then more extensive testing may include full load testing, transient load and line tests to compare with simulation results.

## Load Testing

The setup is the same as the initial startup, except that an additional digital voltmeter is connected between Vin and GND, a load is connected between Vout and GND and a current meter is connected in series between Vout and the load. The load must be able to handle at least rated output power + 50% ( 7.5 watts for this design). Ideally the load is supplied in the form of a variable load test unit. It can also be done in the form of suitably large power resistors. When using an oscilloscope to measure waveforms on the prototype board, the ground leads of the oscilloscope probes should be as short as possible and the area of the loop formed by the ground lead should be kept to a minimum. This will help reduce ground lead inductance and eliminate EMI noise that is not actually present in the circuit.

## Transformer Report

## Transformer Electrical Diagram

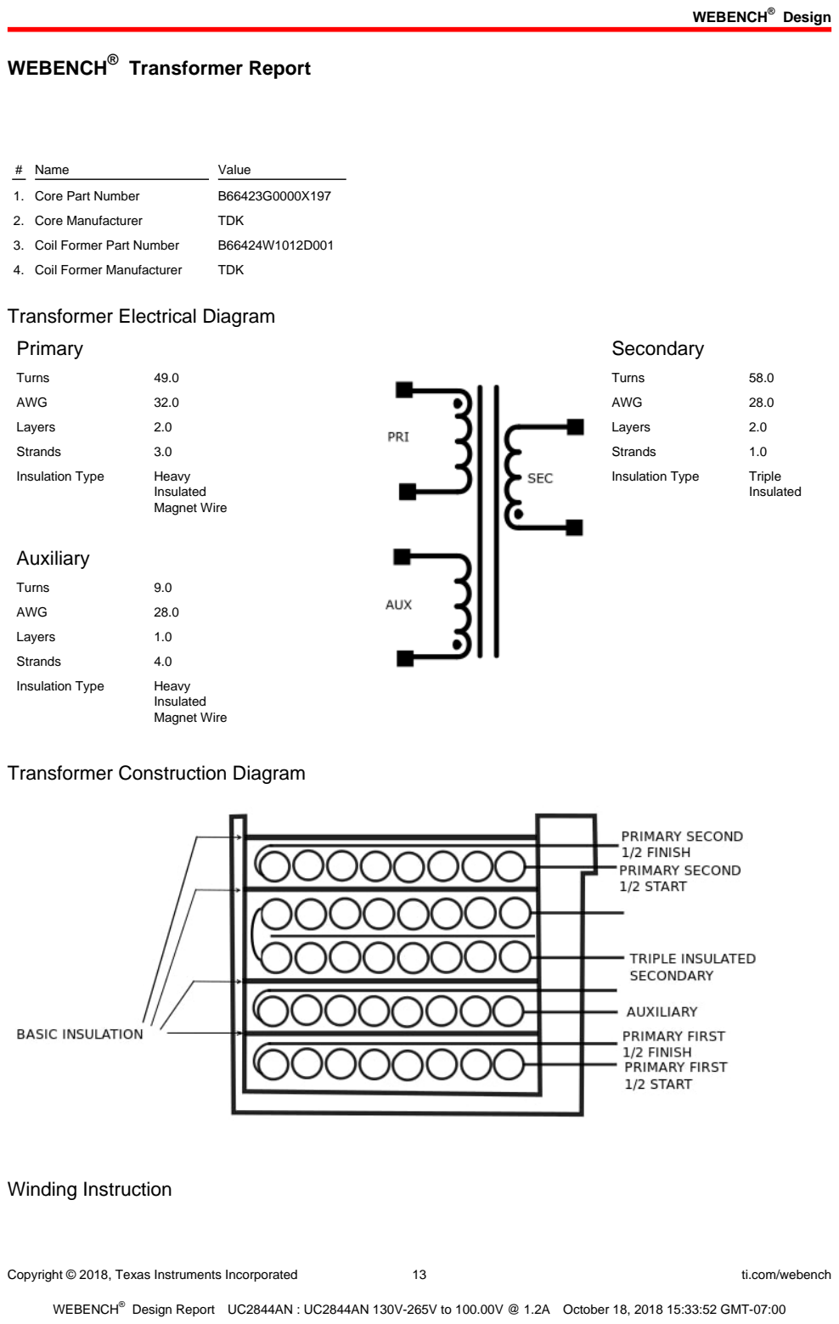
[picture p40: page 13]

Copyright © 2018, Texas Instruments Incorporated | 13 | ti.com/webench
# Name | Value

1. Core Part Number | B66423G0000X197
2. Core Manufacturer | TDK
3. Coil Former Part Number | B66424W1012D001
4. Coil Former Manufacturer | TDK

## Primary

Turns | 49.0
AWG | 32.0
Layers | 2.0
Strands | 3.0
Insulation Type | Heavy
Insulated
Magnet Wire

## Auxiliary

Turns | 9.0
AWG | 28.0
Layers | 1.0
Strands | 4.0
Insulation Type | Heavy
Insulated
Magnet Wire

## Secondary

Turns | 58.0
AWG | 28.0
Layers | 2.0
Strands | 1.0
Insulation Type | Triple Insulated

## Transformer Construction Diagram

## Winding Instruction

Copyright © 2018, Texas Instruments Incorporated | 14 | ti.com/webench
Winding | AWG | Turns | Winding Orientation
Primary First 1/2.0 | 32.0 | 25 | Clockwise
Auxiliary | 28.0 | 9.0 | Counter Clockwise
Triple Insulated Secondary | 28.0 | 58.0 | Counter Clockwise
Primary Second 1/2.0 | 32.0 | 24 | Clockwise

## Transformer Parameters

# Name | Value

1. Lpri | 2.03E-10H
2. Inductance Factor(Al) | 85.0nH
3. Npri | 49.0
4. Nsec | 58.0
5. Naux | 9.0
6. Core Type | EFD30/15/9
7. Core Material | N97
8. Bmax | 0.23T
9. Switching Frequency | 0.10kHz
10. DMax | 0.4
11. Ipk(Primary) | 3.81A
12. Irms(Primary) | 1.54A
13. Ipk(Secondary) | 3.22A
14. Irms(Secondary) | 1.59A

## Design Assistance

1. Master key : 9A3F5B20E88A1102[v1]
2. UC2844A Product Folder : http://www.ti.com/product/UC2844A : contains the data sheet and other resources.

Important Notice and Disclaimer

TI provides technical and reliability data (including datasheets), design resources (including reference designs), application or other design advice, web tools, safety information, and other resources AS IS and with all faults, and disclaims all warranties. These resources are intended for skilled developers designing with TI products. You are solely responsible for (1) selecting the appropriate TI products for your application, (2) designing, validating and testing your application, and (3) ensuring your application meets applicable standards, and any other safety, security, or other requirements.

These resources are subject to change without notice. TI grants you permission to use these resources only for development of an application that uses the TI products described in the resource. Other reproduction and display of these resources is prohibited. No license is granted to any other TI intellectual property right or to any third party intellectual property right. TI disclaims responsibility for, and you will fully indemnify TI and its representatives against, any claims, damages, costs, losses, and liabilities arising out of your use of these resources.

Providing these resources does not expand or otherwise alter TI's applicable Terms of Sale or other applicable terms available either on ti.com or provided in conjunction with TI products.
