josedaparte/TESIS/Documentos utiles/diseño_por_texas_120V1A.pdf

## WEBENCH ® Design Report

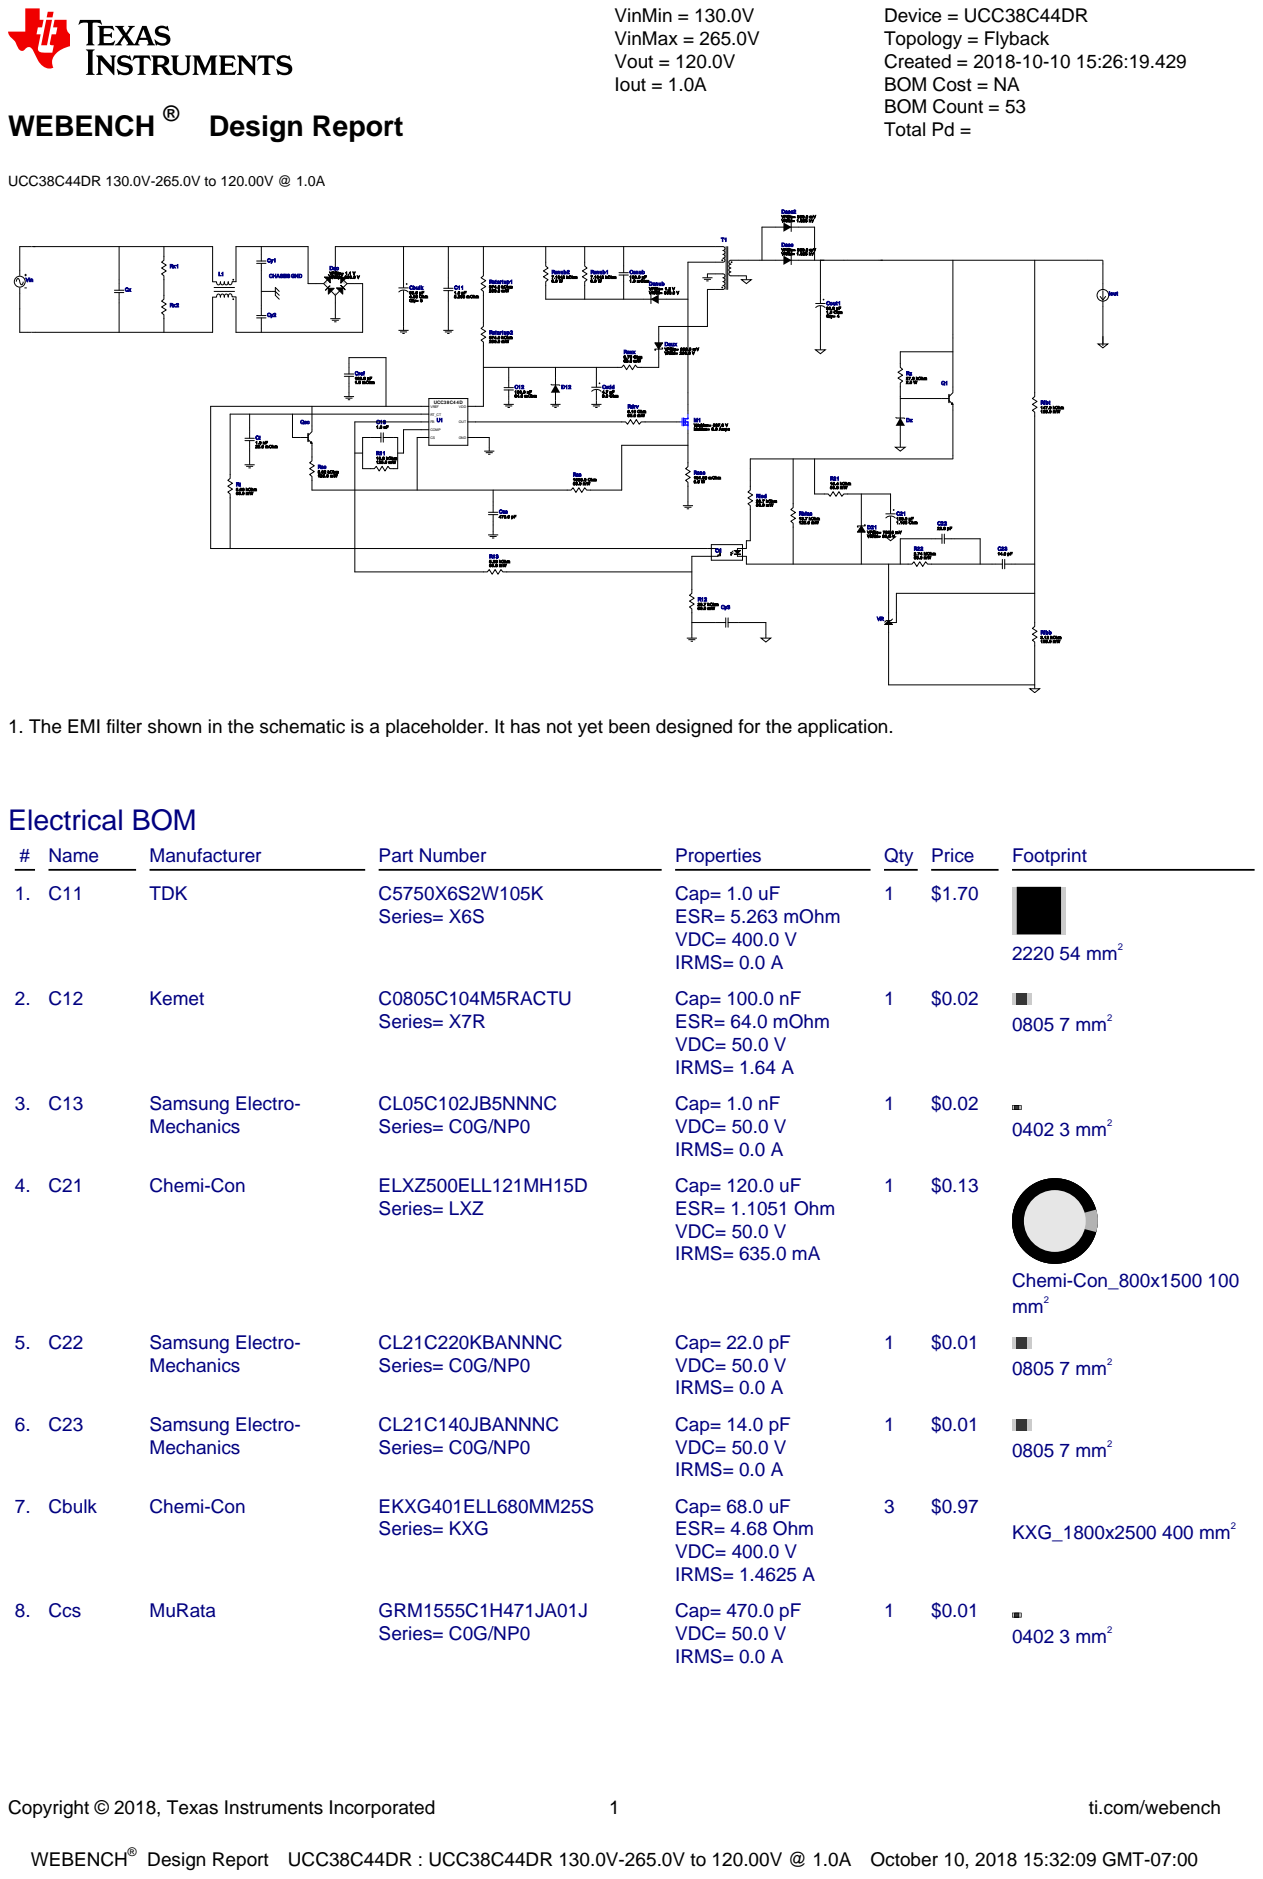
[picture p41: page 1]

Dsec VF@Io= 500.0 mV

1. The EMI filter shown in the schematic is a placeholder. It has not yet been designed for the application.

Design Report UCC38C44DR : UCC38C44DR 130.0V-265.0V to 120.00V @ 1.0A October 10, 2018 15:32:09 GMT-07:00

Design

Copyright © 2018, Texas Instruments Incorporated | 2 | ti.com/webench
# Name | Manufacturer | Part Number | Properties | Qty Price | Footprint

9. Cout1 | Kemet | PEG124YJ2330QL1 (http://capacitoredge.kemet.com/capedge2/DataSheet?pn%3DPEG124YJ2330QL1) Series= 2394 | Cap= 33.0 uF ESR= 1.6 Ohm VDC= 450.0 V IRMS= 306.0 mA
4 | $4.12

PEG124_2000x3700 1008
mm²
10. Cref | MuRata | GRM155R61C104KA88D (http://search.murata.co.jp/Ceramy/PnsearchViewAction.do) Series= X5R

Cap= 100.0 nF
ESR= 1.0 mOhm
VDC= 16.0 V
IRMS= 0.0 A

1 $0.01
0402 3 mm²
11. Csnub | TDK | C3216X7T2W104M160AA Series= X7T

Cap= 100.0 nF
ESR= 1.0 mOhm
VDC= 450.0 V
IRMS= 0.0 A

1 $0.23
1206_180 11 mm²
12. Ct | Kemet | C0805C102J5GACTU (http://capacitoredge.kemet.com/capedge2/DataSheet/Datasheet%2DC0805C102J5GACTU.pdf?pn%3DC0805C102J5GACTU) Series= C0G/NP0

Cap= 1.0 nF
ESR= 25.0 mOhm
VDC= 50.0 V
IRMS= 1.71 A

1 $0.02
0805 7 mm²
13. Cvdd | Chemi-Con | EMVY350ADA4R7MD55G (http://www.chemi%2Dcon.co.jp/cgi%2Dbin/CAT%5FDB/SEARCH/cat%5Fdb%5Fal.cgi?e%3De%26j%3Dp%26pdfname%3Dmvy) Series= MVY | Cap= 4.7 uF ESR= 3.0 Ohm VDC= 35.0 V IRMS= 60.0 mA | 1 | $0.09

CAPSMT_62_D55 28 mm²

14. D12 | Diodes Inc. | MMSZ5248B-7-F (http://www.diodes.com/datasheets/ds18010.pdf) | Zener | 1 | $0.04
SOD-123 13 mm²
15. D21 | Fairchild Semiconductor SS26FL | VF@Io= 700.0 mV
| | | VRRM= 60.0 V | 1 | $0.10
SOD-123F 12 mm²
16. Dac | Diodes Inc. | DF1506S-T (http://www.diodes.com/datasheets/ds17002.pdf) | VF@Io= 1.1 V VRRM= 600.0 V | 1 | $0.23

DF-S 99 mm²
17. Daux | SMC Diode Solutions | SK220ATR (http://www.smc%2Ddiodes.com/propdf/SK220A%20N0942%20REV.A.pdf) | VF@Io= 900.0 mV VRRM= 200.0 V | 1 | $0.04

SMA 37 mm²
18. Dsec | CUSTOM | CUSTOM | VF@Io= 500.0 mV VRRM= 1.625 kV | 1 | NA
CUSTOM 0 mm²
19. Dsec2 | CUSTOM | CUSTOM | VF@Io= 500.0 mV VRRM= 1.625 kV | 1 | NA
CUSTOM 0 mm²
20. Dsnub | Microsemi | UFS180JE3/TR13 | VF@Io= 1.2 V VRRM= 800.0 V | 1 | $0.71

DO-214BA 42 mm²
21. Dz | Diodes Inc. | MMSZ5250B-7-F (http://www.diodes.com/datasheets/ds18010.pdf) | Zener | 1 | $0.04
SOD-123 13 mm²
22. M1 | NA | IdealFET | VdsMax= 597.0 V IdsMax= 5.0 Amps | 1 | NA
NA 0 mm²
23. O1 | Fairchild Semiconductor FOD817A | Optocoupler | 1 | $0.13

DIP-4 71 mm²
24. Q1 | Nexperia | MMBTA42 (http://www.nxp.com/documents/data%5Fsheet/MMBTA42.pdf) | Bipolar Transistor | 1 | $0.05

SOT-23 14 mm²
25. Qsc | STMicroelectronics | 2N2222A (http://www.st.com/web/en/resource/technical/document/datasheet/CD00003223.pdf) | Bipolar Transistor | 1 | $1.02

TO-18 57 mm²
26. R11 | Vishay-Dale | CRCW080510K0FKEA (http://www.vishay.com/docs/20035/dcrcwe3.pdf) Series= CRCW..e3 | Res= 10.0 kOhm Power= 125.0 mW Tolerance= 1.0% | 1 | $0.01
0805 7 mm²

Copyright © 2018, Texas Instruments Incorporated | 3 | ti.com/webench
# Name | Manufacturer | Part Number | Properties | Qty Price | Footprint

27. R12 | Yageo | RC0201FR-0723K7L (http://www.yageo.com/exep/pages/download/literatures/PYu%2DR%5FMarking%5F2.pdf) Series= ? | Res= 23.7 kOhm Power= 50.0 mW Tolerance= 1.0%
1 | $0.01
| | | | | 0201 2 mm²
28. R13 | Vishay-Dale | CRCW04025K23FKED (http://www.vishay.com/docs/20035/dcrcwe3.pdf) Series= CRCW..e3 | Res= 5.23 kOhm Power= 63.0 mW Tolerance= 1.0%
1 | $0.01
| | | | | 0402 3 mm²
29. R21 | Yageo | RC0201FR-0715K4L (http://www.yageo.com/exep/pages/download/literatures/PYu%2DR%5FMarking%5F2.pdf) Series= ? | Res= 15.4 kOhm Power= 50.0 mW Tolerance= 1.0%
1 | $0.01
| | | | | 0201 2 mm²
30. R22 | Vishay-Dale | CRCW04022M74FKED (http://www.vishay.com/docs/20035/dcrcwe3.pdf) Series= CRCW..e3 | Res= 2.74 MOhm Power= 63.0 mW Tolerance= 1.0%
1 | $0.01
| | | | | 0402 3 mm²
31. Raux | Vishay-Dale | CRCW04029R76FKED (http://www.vishay.com/docs/20035/dcrcwe3.pdf) Series= CRCW..e3 | Res= 9.76 Ohm Power= 63.0 mW Tolerance= 1.0%
1 | $0.01
| | | | | 0402 3 mm²
32. Rbias | Panasonic | ERJ-6ENF1372V Series= ERJ-6E | Res= 13.7 kOhm Power= 125.0 mW Tolerance= 1.0%
1 | $0.01
| | | | | 0805 7 mm²
33. Rcs | Vishay-Dale | CRCW04021K00FKED (http://www.vishay.com/docs/20035/dcrcwe3.pdf) Series= CRCW..e3 | Res= 1000.0 Ohm Power= 63.0 mW Tolerance= 1.0%
1 | $0.01
| | | | | 0402 3 mm²
34. Rdrv | Vishay-Dale | CRCW04026R19FKED (http://www.vishay.com/docs/20035/dcrcwe3.pdf) Series= CRCW..e3 | Res= 6.19 Ohm Power= 63.0 mW Tolerance= 1.0%
1 | $0.01
| | | | | 0402 3 mm²
35. Rfbb | Yageo | RT0805BRD073K12L (http://www.yageo.com/documents/recent/PYu%2DRT%5F1%2Dto%2D0.05%5FRoHS%5FL%5F6.pdf) Series= ? | Res= 3.12 kOhm Power= 125.0 mW Tolerance= 0.1%
1 | $0.05
| | | | | 0805 7 mm²
36. Rfbt | Panasonic | ERJ-6ENF1473V Series= ERJ-6E | Res= 147.0 kOhm Power= 125.0 mW Tolerance= 1.0%
1 | $0.01
| | | | | 0805 7 mm²
37. Rled | Yageo | RC0201FR-0728K7L (http://www.yageo.com/exep/pages/download/literatures/PYu%2DR%5FMarking%5F2.pdf) Series= ? | Res= 28.7 kOhm Power= 50.0 mW Tolerance= 1.0%
1 | $0.01
| | | | | 0201 2 mm²
38. Rsc | Vishay-Dale | CRCW08053K92FKEA (http://www.vishay.com/docs/20035/dcrcwe3.pdf) Series= CRCW..e3 | Res= 3.92 kOhm Power= 125.0 mW Tolerance= 1.0%
1 | $0.01
| | | | | 0805 7 mm²
39. Rsns | CUSTOM | CUSTOM Series= ? | Res= 181.89 mOhm Power= 0.0 W Tolerance= 0.0%
1 | NA
| | | | | CUSTOM 0 mm²
40. Rsnub1 | CUSTOM | CUSTOM Series= ? | Res= 7.1042 kOhm Power= 0.0 W Tolerance= 0.0%
1 | NA
| | | | | CUSTOM 0 mm²
41. Rsnub2 | CUSTOM | CUSTOM Series= ? | Res= 7.1042 kOhm Power= 0.0 W Tolerance= 0.0%
1 | NA
| | | | | CUSTOM 0 mm²
42. Rstartup1 Yageo | RC1206FR-07374KL (http://www.yageo.com/documents/recent/PYu%2DRC1206%5F51%5FRoHS%5FL%5F6.pdf)
| | Series= ? | Res= 374.0 kOhm Power= 250.0 mW Tolerance= 1.0%
1 | $0.01
| | | | | 1206 11 mm²
43. Rstartup2 Yageo | RC1206FR-07374KL (http://www.yageo.com/documents/recent/PYu%2DRC1206%5F51%5FRoHS%5FL%5F6.pdf)
| | Series= ? | Res= 374.0 kOhm Power= 250.0 mW Tolerance= 1.0%
1 | $0.01
| | | | | 1206 11 mm²
44. Rt | Vishay-Dale | CRCW04028K66FKED (http://www.vishay.com/docs/20035/dcrcwe3.pdf) Series= CRCW..e3 | Res= 8.66 kOhm Power= 63.0 mW Tolerance= 1.0%
1 | $0.01
| | | | | 0402 3 mm²
45. Rz | Stackpole Electronics Inc RSMF2JT27K0 (http://www.seielect.com/Catalog/SEI%2DRSF%5FRSMF.pdf)
| | Series= ? | Res= 27.0 kOhm Power= 2.0 W Tolerance= 5.0%
1 | $0.02
| | | | | RSMF2 148 mm²

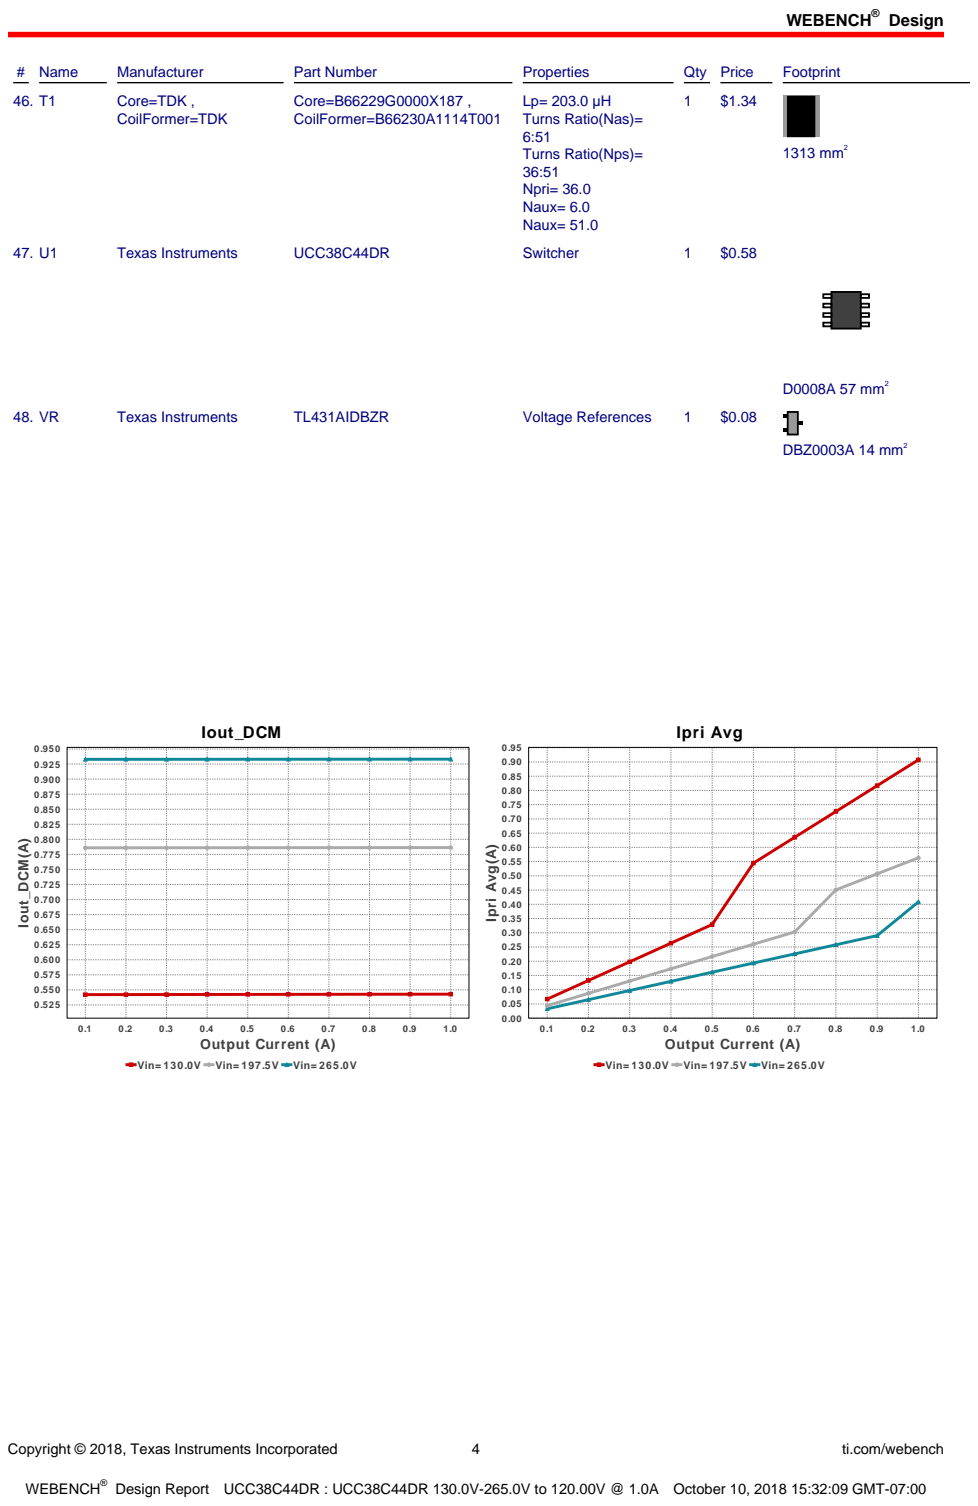
[picture p42: page 4]
Copyright © 2018, Texas Instruments Incorporated; ti.com/webench; # Name; Manufacturer; Part Number; Properties; Qty Price; Footprint; Core=TDK ,; CoilFormer=TDK; Core=B66229G0000X187 , CoilFormer=B66230A1114T001; Lp= 203.0 µH Turns Ratio(Nas)= 6:51 Turns Ratio(Nps)= 36:51 Npri= 36.0 Naux= 6.0 Naux= 51.0; 1313 mm²; Texas Instruments; UCC38C44DR; Switcher; D0008A 57 mm²; TL431AIDBZR; Voltage References; DBZ0003A 14 mm²; Iout_DCM; 1.0 Output Current (A); Iout_DCM(A); Ipri Avg; Ipri Avg(A)

Vin= 130.0V Vin= 197.5V Vin= 265.0V

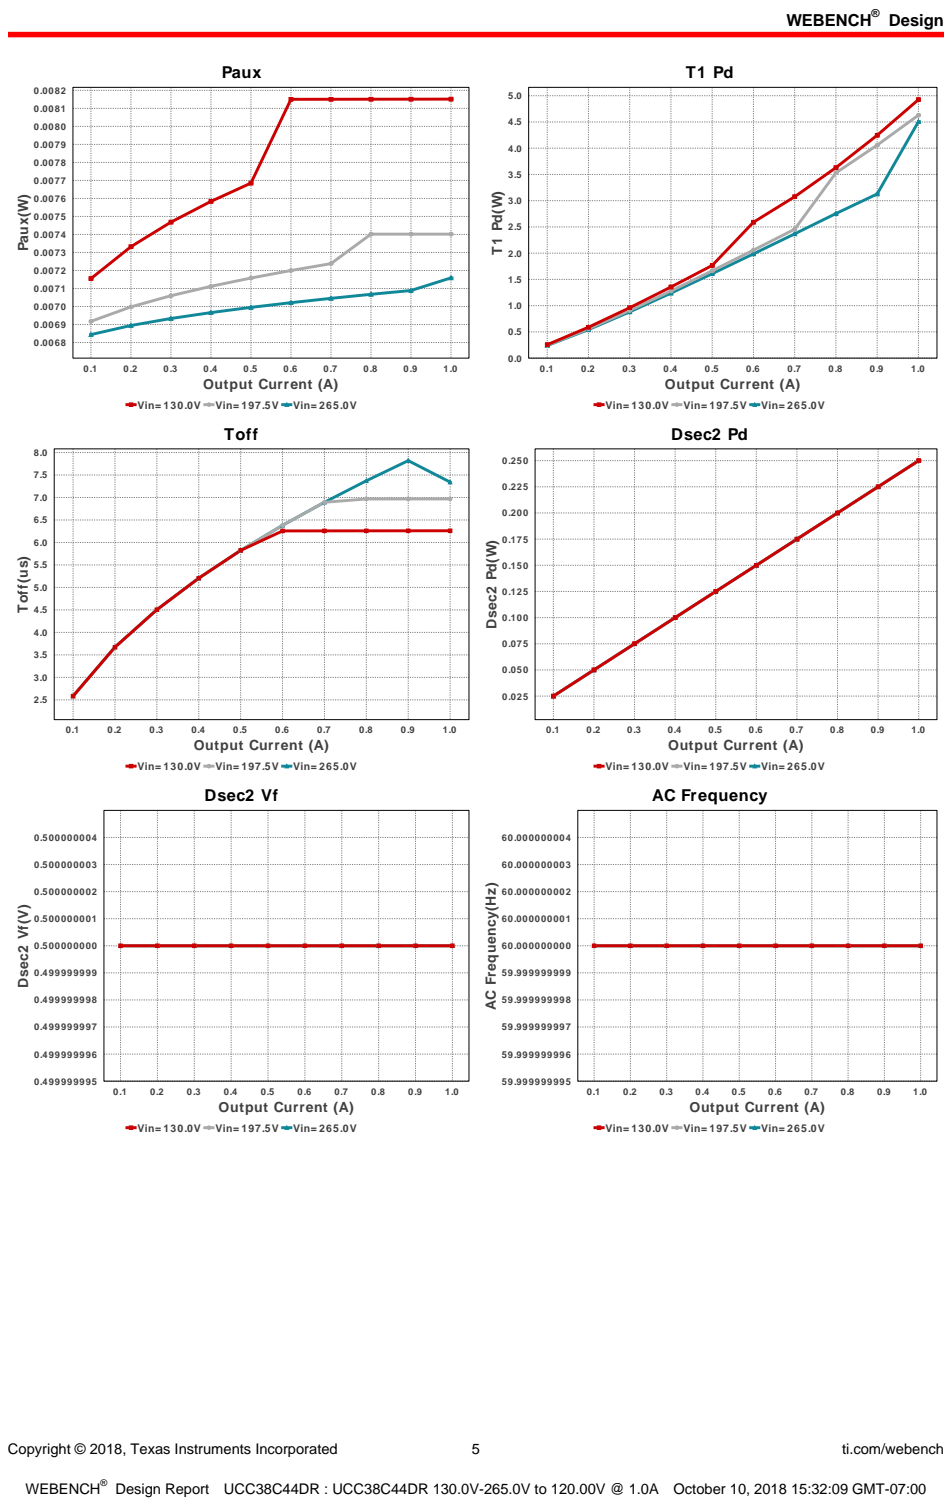
[picture p43: page 5]
Copyright © 2018, Texas Instruments Incorporated; ti.com/webench; Paux; 1.0 Output Current (A); Paux(W); Toff; Toff(us); Dsec2 Pd; Dsec2 Pd(W); Dsec2 Vf; Dsec2 Vf(V)

Vin= 130.0V Vin= 197.5V Vin= 265.0V

AC Frequency

AC Frequency(Hz)

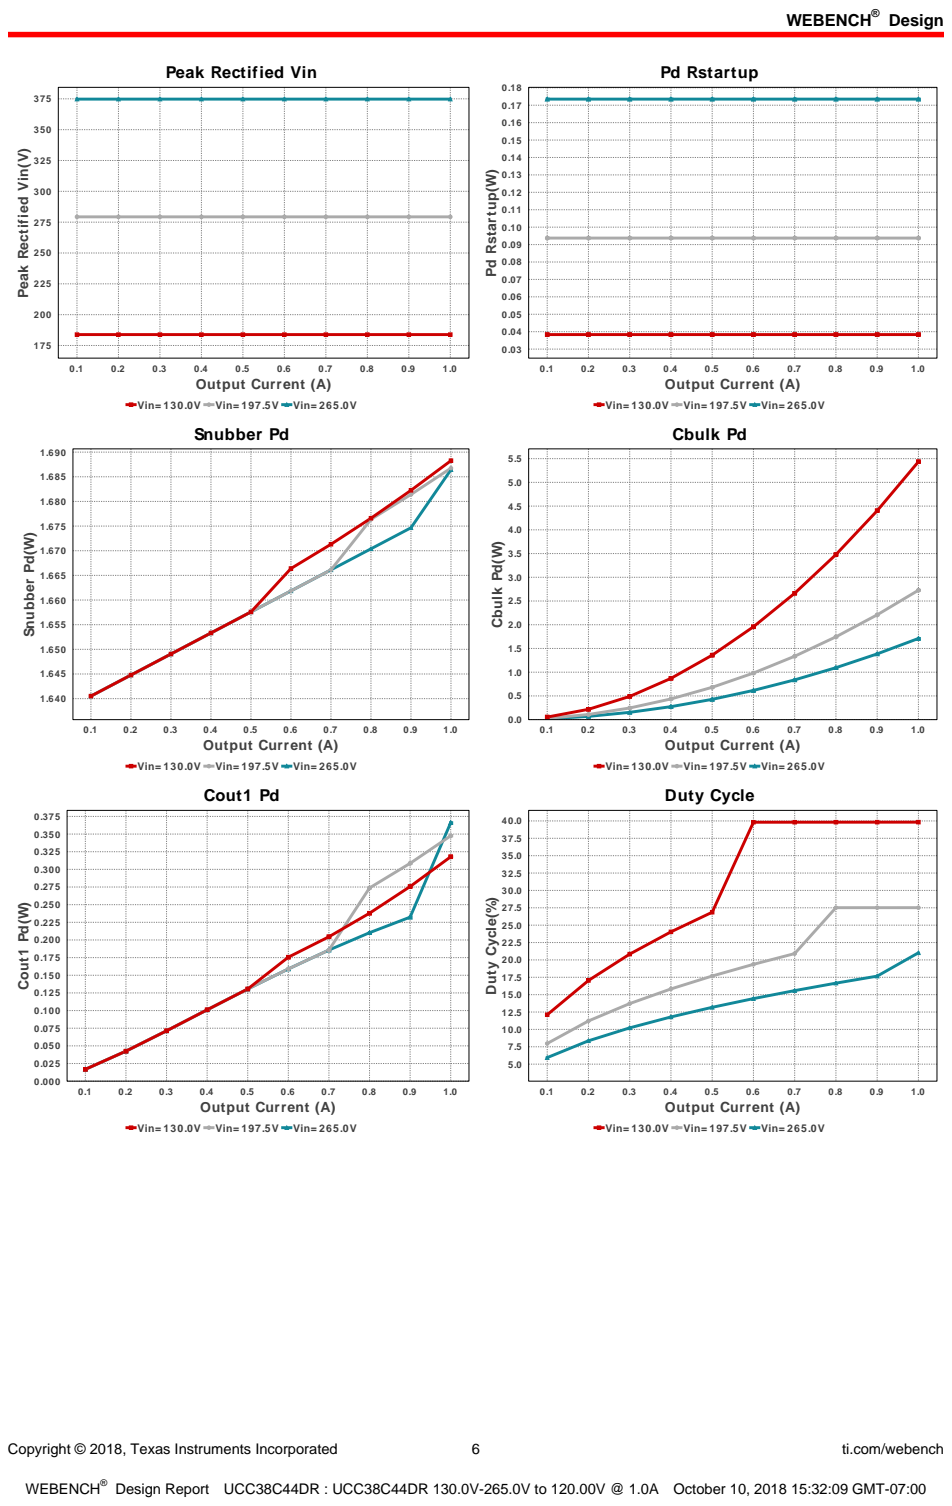
[picture p44: page 6]
Copyright © 2018, Texas Instruments Incorporated; ti.com/webench; 1.0 Output Current (A); Pd Rstartup; Pd Rstartup(W); Snubber Pd(W); Cbulk Pd; Cbulk Pd(W); Cout1 Pd; Cout1 Pd(W); Duty Cycle; Duty Cycle(%)

Peak Rectified Vin

Peak Rectified Vin(V)

Vin= 130.0V Vin= 197.5V Vin= 265.0V
Snubber Pd

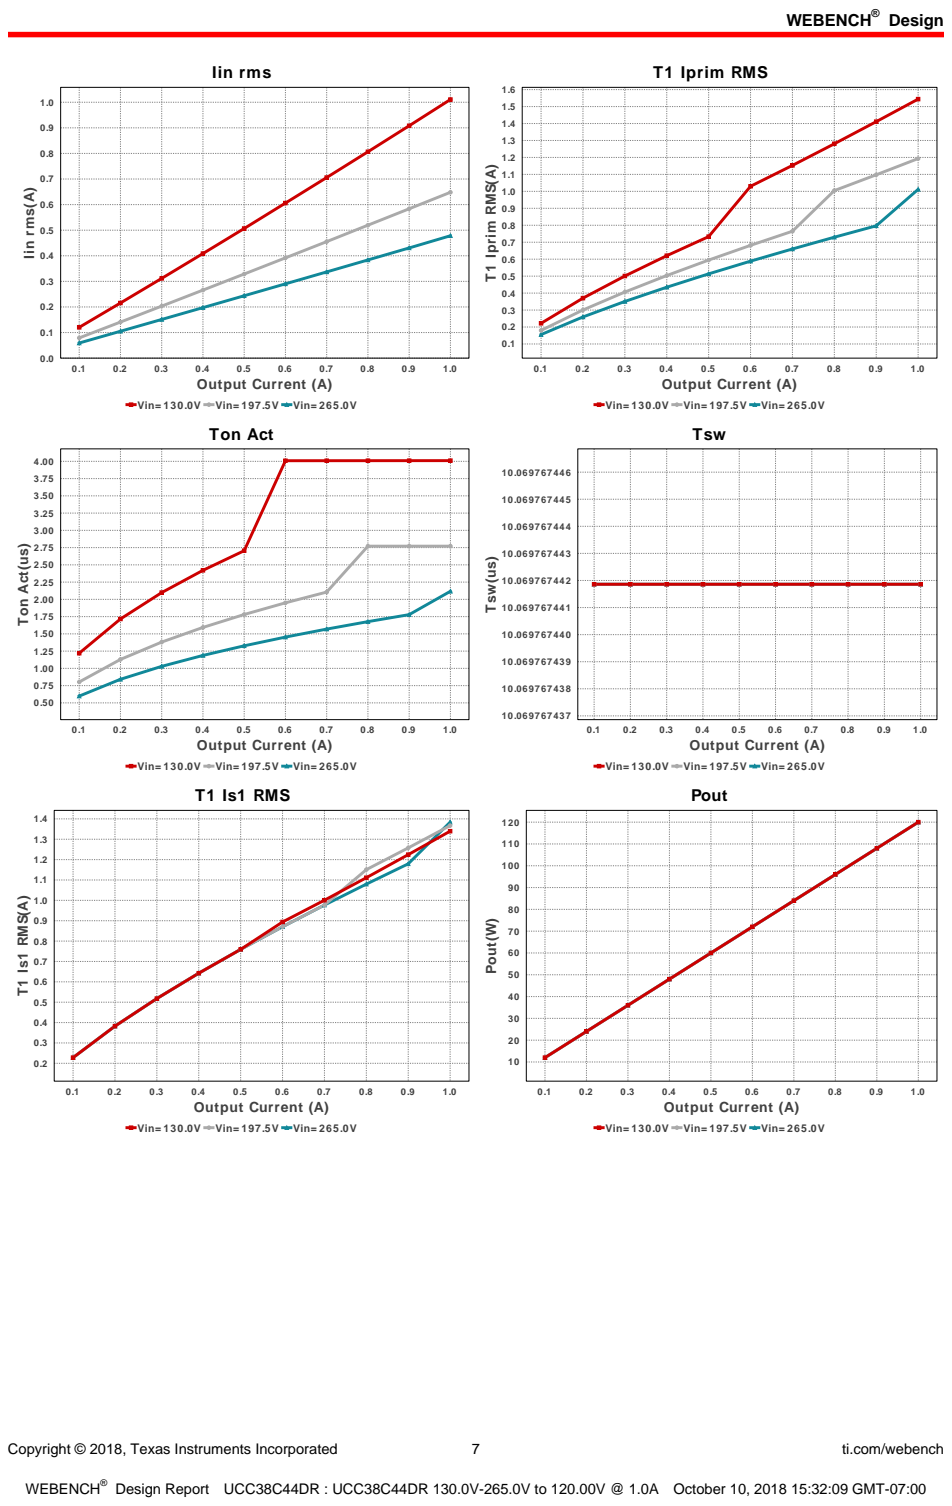
[picture p45: page 7]
Copyright © 2018, Texas Instruments Incorporated; ti.com/webench; Iin rms; 1.0 Output Current (A); Iin rms(A); T1 Iprim RMS; T1 Iprim RMS(A); Ton Act; Tsw; Tsw(us); T1 Is1 RMS(A); Pout; Pout(W)

Vin= 130.0V Vin= 197.5V Vin= 265.0V

Ton Act(us)

T1 Is1 RMS

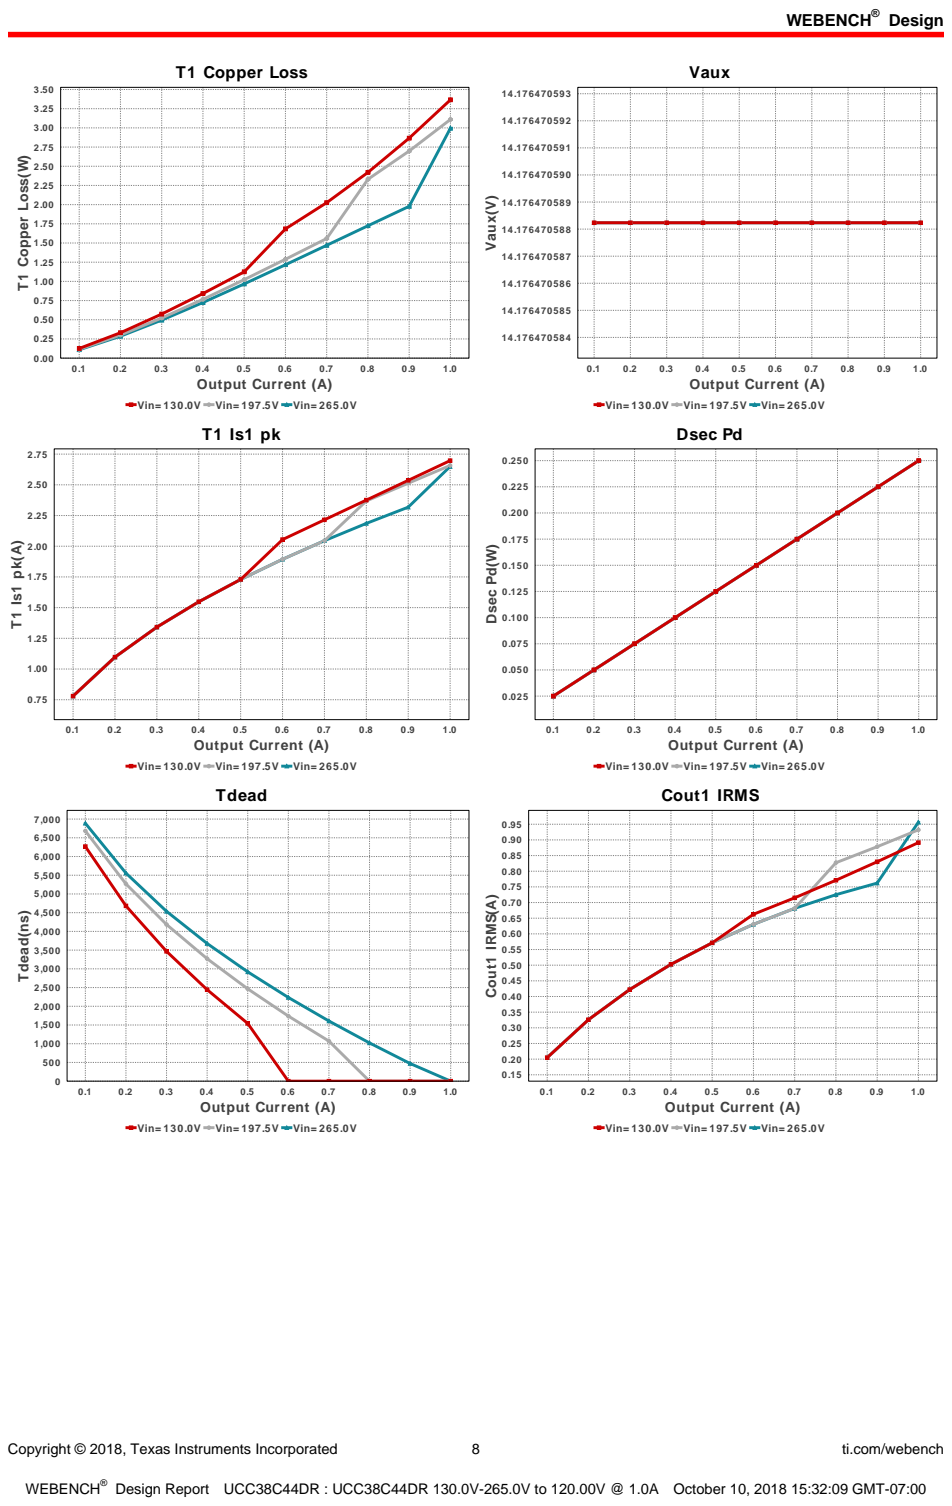
[picture p46: page 8]
Copyright © 2018, Texas Instruments Incorporated; ti.com/webench; T1 Copper Loss; 1.0 Output Current (A); T1 Copper Loss(W); Vaux; Vaux(V); Dsec Pd; Dsec Pd(W); Tdead; Tdead(ns); Cout1 IRMS(A)

Vin= 130.0V Vin= 197.5V Vin= 265.0V

Cout1 IRMS

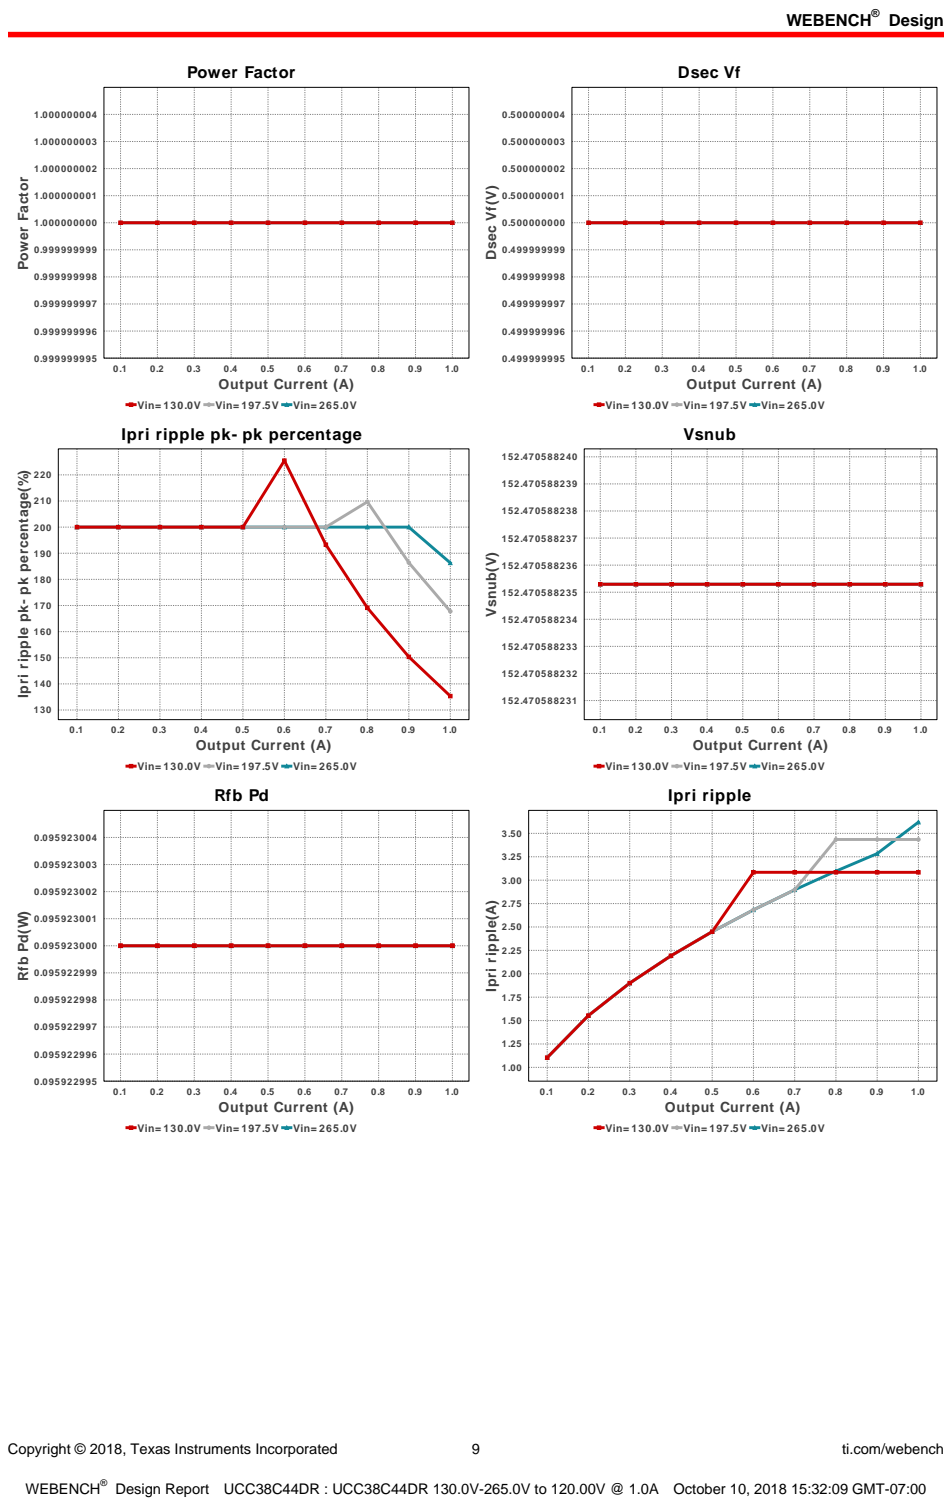
[picture p47: page 9]
Copyright © 2018, Texas Instruments Incorporated; ti.com/webench; Power Factor; 1.0 Output Current (A); Dsec Vf; Dsec Vf(V); Vsnub; Vsnub(V); Rfb Pd; Rfb Pd(W); Ipri ripple; Ipri ripple(A)

Vin= 130.0V Vin= 197.5V Vin= 265.0V
Ipri ripple pk- pk percentage

Ipri ripple pk- pk percentage(%)

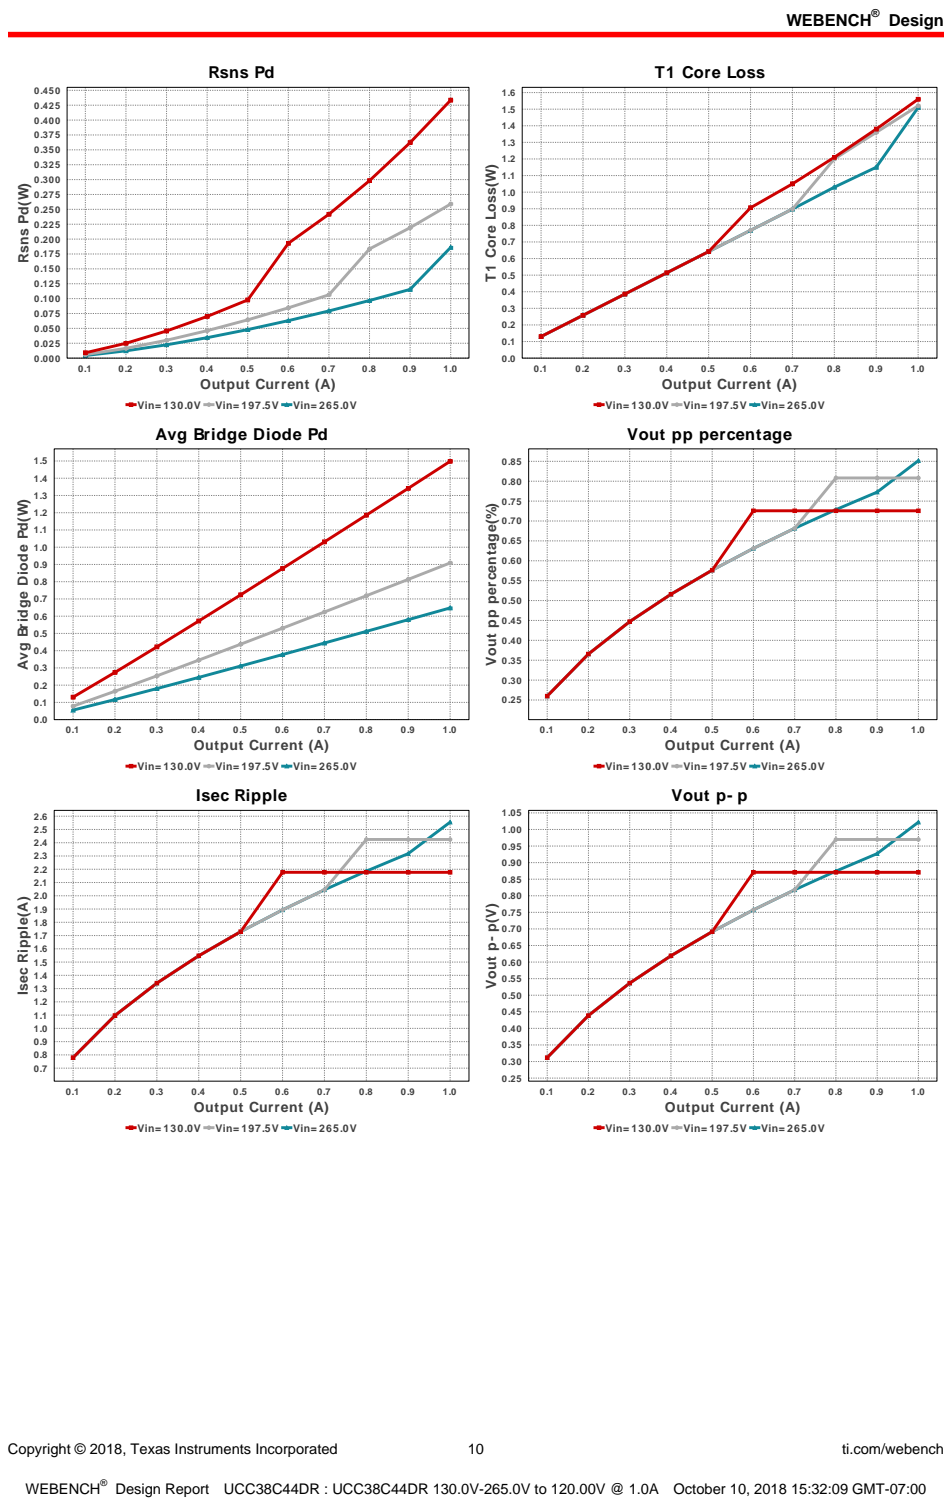
[picture p48: page 10]
Copyright © 2018, Texas Instruments Incorporated; ti.com/webench; Rsns Pd; 1.0 Output Current (A); Rsns Pd(W); T1 Core Loss; T1 Core Loss(W); Isec Ripple; Isec Ripple(A); Vout p- p; Vout p- p(V)

Vin= 130.0V Vin= 197.5V Vin= 265.0V
Avg Bridge Diode Pd

Vout pp percentage

Avg Bridge Diode Pd(W)

Vout pp percentage(%)

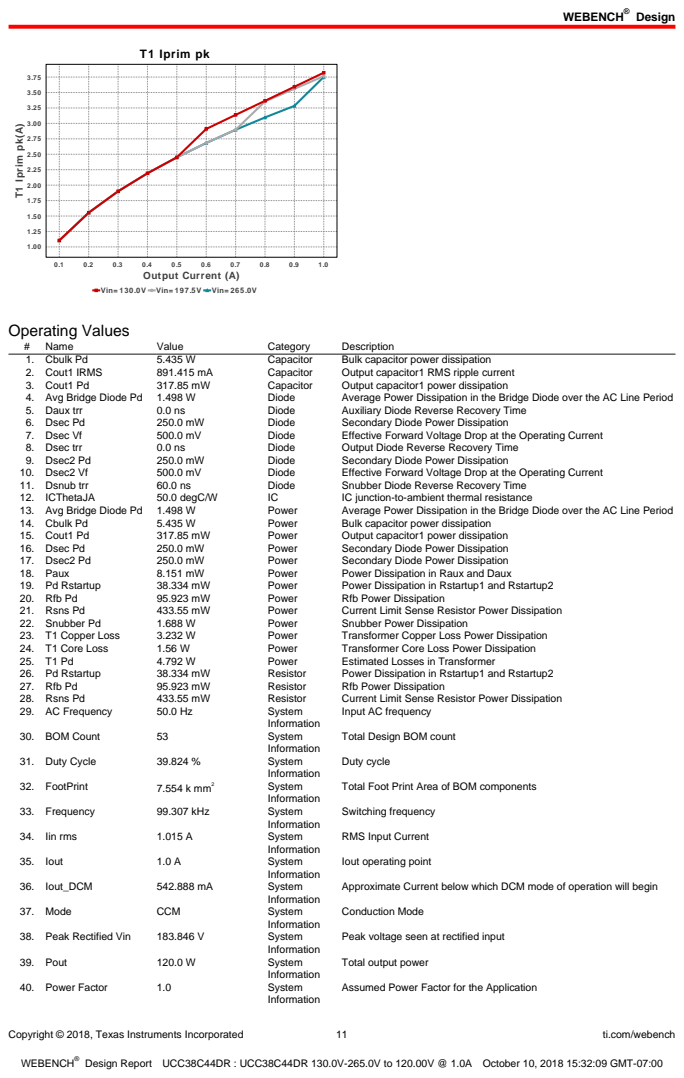
[picture p49: page 11]
Copyright © 2018, Texas Instruments Incorporated; ti.com/webench; T1 Iprim pk; 1.0 Output Current (A); T1 Iprim pk(A); Operating Values; Name; Value; Category; Description; 1. Cbulk Pd; Capacitor; Bulk capacitor power dissipation; 2. Cout1 IRMS; Output capacitor1 RMS ripple current; 3. Cout1 Pd; Output capacitor1 power dissipation; 4. Avg Bridge Diode Pd 1.498 W; Diode; Average Power Dissipation in the Bridge Diode over the AC Line Period; 5. Daux trr; Auxiliary Diode Reverse Recovery Time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

Vin= 130.0V Vin= 197.5V Vin= 265.0V

Input AC frequency

Total Design BOM count

Total Foot Print Area of BOM components

RMS Input Current

Iout operating point

Approximate Current below which DCM mode of operation will begin

Peak voltage seen at rectified input

Total output power

Assumed Power Factor for the Application

Copyright © 2018, Texas Instruments Incorporated | 12 | ti.com/webench
# | Name | Value | Category | Description

41. Tdead | 0.0 ns | System
| | | Information | Approximate Dead Time of the Regulator
42. Toff | 6.26 us | System
| | | Information | Approximate Converter Off Time
43. Ton Act | 4.01 us | System
| | | Information | Approximate Converter On Time
44. Total BOM | NA | System
| | | Information | Total BOM Cost
45. Tsw | 10.07 us | System
| | | Information | Switching Time Period
46. Vin_RMS | 130.0 V | System
| | | Information | Vin operating point
47. Vout | 120.0 V | System
| | | Information | Operational Output Voltage
48. Vout Actual | 120.048 V | System
| | | Information | Vout Actual calculated based on selected voltage divider resistors
49. Vout Tolerance | 1.402 % | System
| | | Information | Vout Tolerance based on IC Tolerance (no load) and voltage divider resistors if applicable
50. Vout p-p | 870.716 mV | System
| | | Information | Peak-to-peak output ripple voltage
51. Vout pp percentage | 725.597 m% | System
| | | Information | Output Voltage ripple percentage
52. Vsnub | 152.471 V | System
| | | Information | Voltage Across the Snubber
53. Ipri Avg | 907.503 mA | Transformer | Average Current in Primary Winding over the complete Switching
| | | | Period
54. Ipri ripple | 3.084 A | Transformer | Ripple Current in the Primary Winding
55. Ipri ripple pk-pk
| percentage | 135.326 % | Transformer | Primary Current pk-pk ripple percentage(of Ipri avg during ton only)
56. Isec Ripple | 2.177 A | Transformer | Ripple Current in the Secondary Winding
57. Paux | 8.151 mW | Transformer | Power Dissipation in Raux and Daux
58. T1 Copper Loss | 3.232 W | Transformer | Transformer Copper Loss Power Dissipation
59. T1 Core Loss | 1.56 W | Transformer | Transformer Core Loss Power Dissipation
60. T1 Iprim RMS | 1.544 A | Transformer | Transformer Primary RMS Current
61. T1 Iprim pk | 3.821 A | Transformer | Transformer Primary Peak Current
62. T1 Is1 RMS | 1.34 A | Transformer | Transformer Secondary1 RMS Current
63. T1 Is1 pk | 2.697 A | Transformer | Transformer Secondary1 Peak Current
64. T1 Pd | 4.792 W | Transformer | Estimated Losses in Transformer
65. Vaux | 14.176 V | Transformer | Auxiliary Voltage

## Design Inputs

# | Name | Value | Description

1. Iout | 1.0 | Maximum Output Current
2. VinMax | 265.0 | Maximum input voltage
3. VinMin | 130.0 | Minimum input voltage
4. Vout | 120.0 | Output Voltage
5. acFrequency | 50.0 | AC Frequency
6. base_pn | UCC38C44 | Base Product Number
7. source | AC | Input Source Type
8. Ta | 30.0 | Ambient temperature

## Design Assistance

1. UCC38C44 Product Folder : http://www.ti.com/product/UCC38C44 : contains the data sheet and other resources.

Important Notice and Disclaimer

TI provides technical and reliability data (including datasheets), design resources (including reference designs), application or other design advice, web tools, safety information, and other resources AS IS and with all faults, and disclaims all warranties. These resources are intended for skilled developers designing with TI products. You are solely responsible for (1) selecting the appropriate TI products for your application, (2) designing, validating and testing your application, and (3) ensuring your application meets applicable standards, and any other safety, security, or other requirements.

These resources are subject to change without notice. TI grants you permission to use these resources only for development of an application that uses the TI products described in the resource. Other reproduction and display of these resources is prohibited. No license is granted to any other TI intellectual property right or to any third party intellectual property right. TI disclaims responsibility for, and you will fully indemnify TI and its representatives against, any claims, damages, costs, losses, and liabilities arising out of your use of these resources.

Providing these resources does not expand or otherwise alter TI's applicable Terms of Sale or other applicable terms available either on ti.com or provided in conjunction with TI products.
