josedaparte/TESIS/Kikad_PCBs/PWM_JOSE_v1/PCB_terminado_v1.pdf

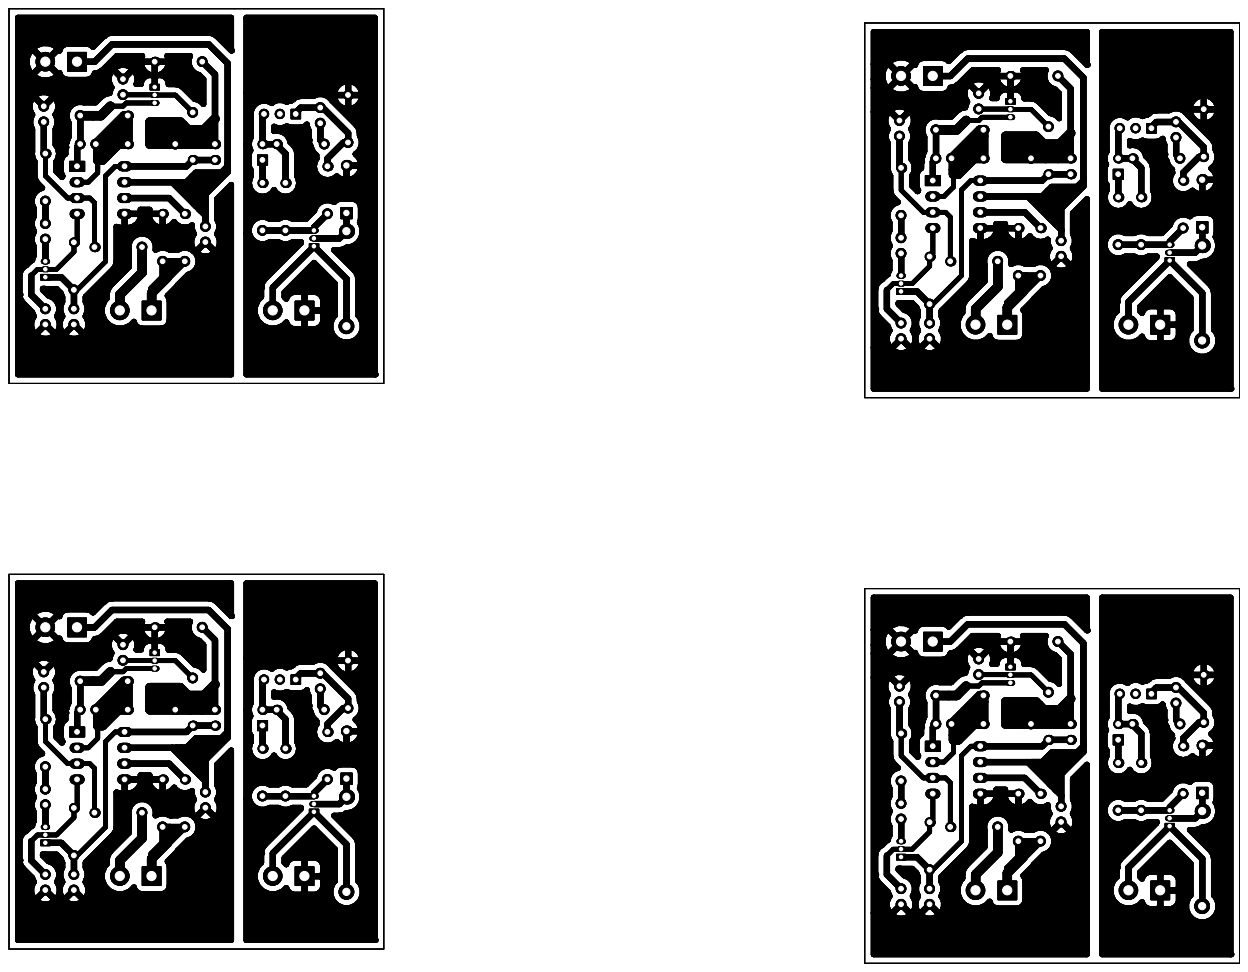
[picture p50: page 1]
