josedaparte/TESIS/Kikad_PCBs/MOSFET/PCB_MOSFET.pdf

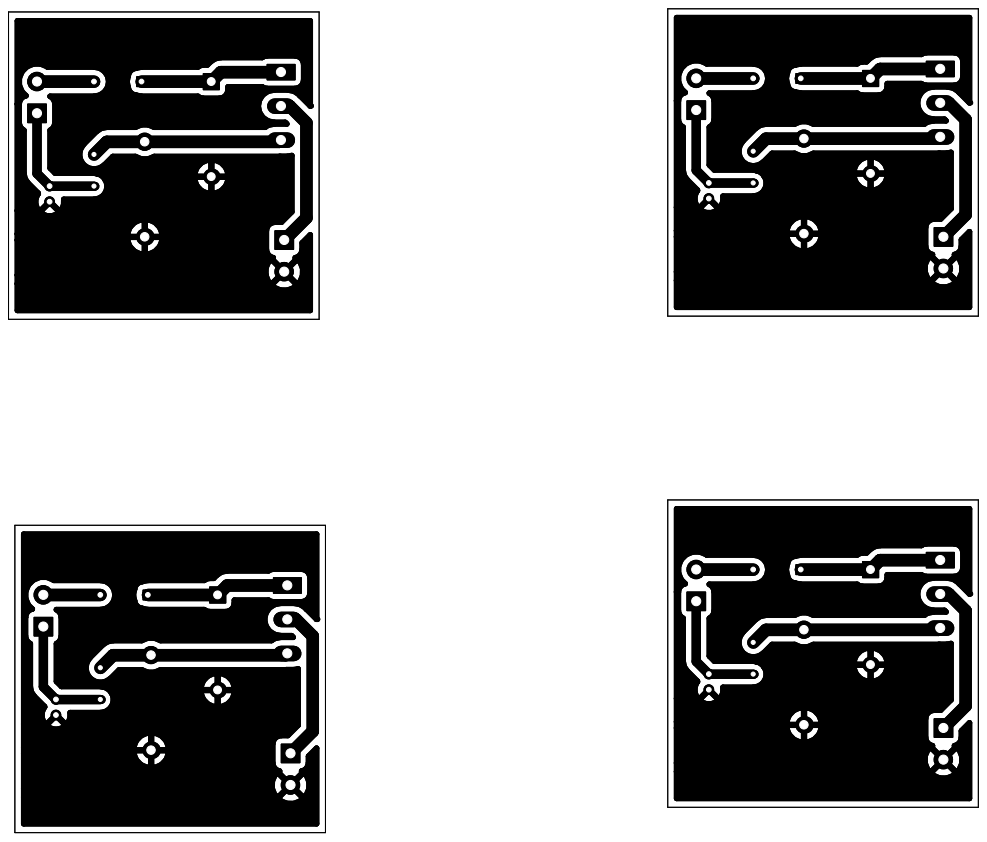
[picture p51: page 1]
