josedaparte/TESIS/Kikad_PCBs/PCB_JOSE_despues_trafo/PCB_final.pdf

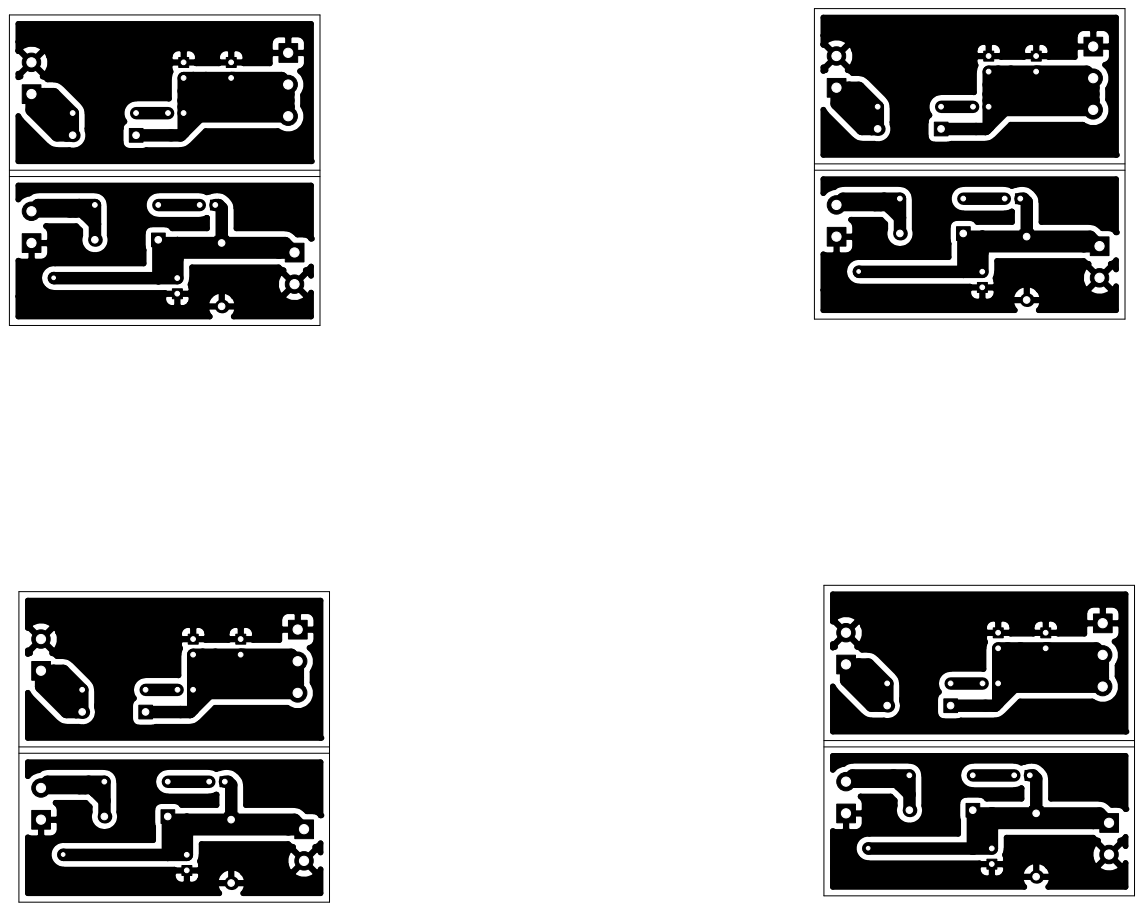
[picture p52: page 1]
