josedaparte/TESIS/(list of files, drawings)

Other design files:
Simulaciones/CircuitoTL431yOPTO.ms14
Simulaciones/flyback_con_control_temp.ms14
Simulaciones/flyback_de_corriente.ms14
Simulaciones/fuente-PSpiceFiles/schematic1/FLYBACK.DSN
Simulaciones/fuente-PSpiceFiles/schematic1/flyback.opj
Simulaciones/FUENTE.DSN
Simulaciones/fuente.opj
