josedaparte/TESIS/Kikad_PCBs/PCB_JOSE_despues_trafo/PCB_JOSE_despues_trafo.kicad_pcb

## KiCad design Kikad_PCBs/PCB_JOSE_despues_trafo/PCB_JOSE_despues_trafo.kicad_pcb (2018-04-30)

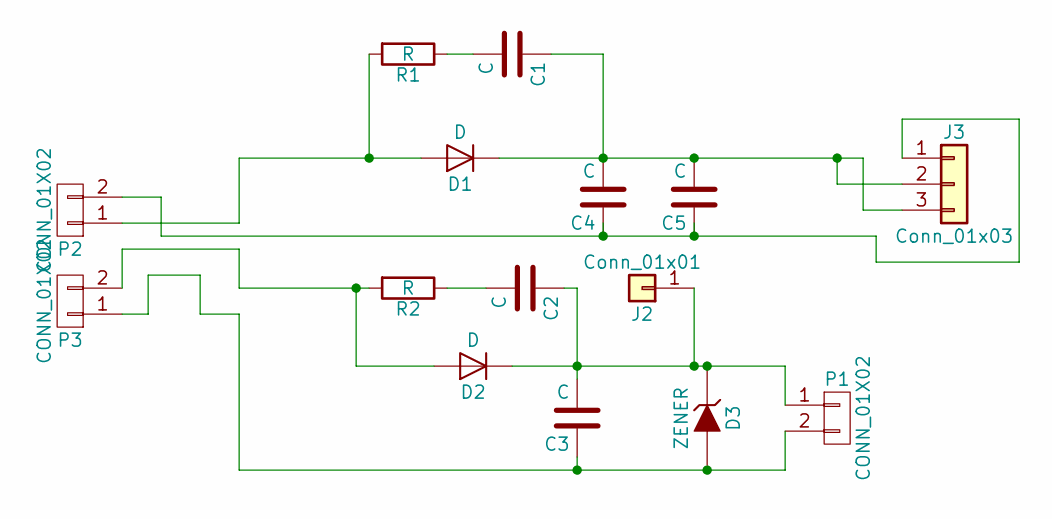
[picture p53: schematic PCB_JOSE_despues_trafo.sch]

Parts:
C1, C2, C3, C4, C5: C; CP_Radial_D6.3mm_P2.50mm
D1, D2: D; D_DO-41_SOD81_P10.16mm_Horizontal
D3: ZENER; D_DO-41_SOD81_P10.16mm_Horizontal
J2: Conn_01x01; PINTST
J3: Conn_01x03; bornier3
P1, P2, P3: CONN_01X02; bornier2
R1, R2: R; R_Axial_DIN0207_L6.3mm_D2.5mm_P10.16mm_Horizontal

Connections:
unnamed: C1.1, C4.2, C5.2, D1.1 (K), J3.2, J3.3
unnamed: C1.2, R1.1
unnamed: C2.1, C3.2, D2.1 (K), D3.1 (K), J2.1, P1.1
unnamed: C2.2, R2.1
unnamed: C3.1, D3.2 (A), P1.2, P3.1
unnamed: C4.1, C5.1, J3.1, P2.2
unnamed: D1.2 (A), P2.1, R1.2
unnamed: D2.2 (A), P3.2, R2.2

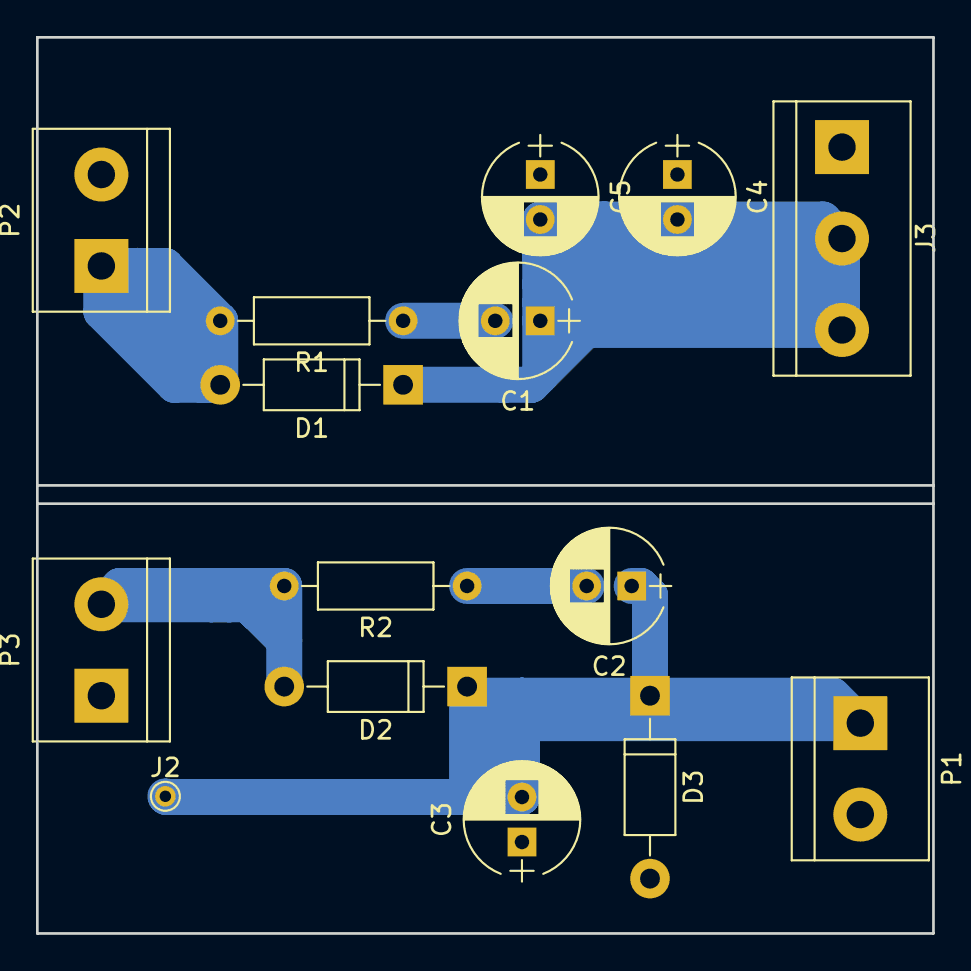
[picture p54: board PCB_JOSE_despues_trafo.kicad_pcb from above]

Board: 2 copper layers, 49.8 x 49.8 mm, 15 parts (0 on the bottom side), 8 nets.
