josedaparte/TESIS/(commit log)

2018-04-30 Agrego los proyectos de KiCAD del mosfet ultimo implementado y del circuito posterior al transformador
    [MOSFET.kicad_pcb, MOSFET.sch, PCB_JOSE_despues_trafo.kicad_pcb, PCB_JOSE_despues_trafo.sch]
2018-05-04 Creacion carpeta datasheets, paginas y documentos utiles
    doc y pag utiles son ejemplos de uso de integrados, esxplicaciones de circuitos y de funcionamiento de cosas que pueden ser de utilidad
    [MOSFET.kicad_pcb, MOSFET.sch, PCB_JOSE_despues_trafo.kicad_pcb, PCB_JOSE_despues_trafo.sch]
2018-05-08 Comienzo diseño PWM propio
    creo la carpeta Diseño_PWM, para poner todo lo referido a este, y tambien el documento de lyx que sera un tipomanual donde esta todo el diseño paso a paso y las explicaciones de todo
2018-05-22 continuación informe pwm y agrego simulacion de fuente de corriente
    en la carpeta simulaciones agrego la simulacion de la fuente flyback con el control nuevo para que sea fuente de corriente, esta regula a 2.1A independientemente de la carga.
    si al cambiar la carga regula a menos corriente de para la que esta diseñada es porque se la esta limitando desde la pata isense del primario (maxima corriente del primario), para no romper todo por potencia
    agregado de cosas al informe de diseño del pwm.
    agregado de datasheets y pdfs utiles
    [flyback_de_corriente.ms14]
2018-10-11 Calculo Fuente Matlab, docuumentos importantes y simulaciones.
    Documentos nuevos: identificar trafo saturado
    uc3842 explicacion español
    diseño de fuente flyback paso a paso por texas instruments
    Creacion de scripts de MATLAB, son 2 uno siguiendo el diseño de texas y uno propio, donde al correrlo se calcula paso por paso cada componente del circuito. llegue hasta 9.2.2.8
    [ADSDSA.DSN, DESIGN1.DSN, DESIGN2.DSN, DESIGN3.DSN, Design1.opj, Design2.opj, Design3.opj, FLYBACK.DSN]
2018-10-11 Correccion, el documento agregado anteriormente era otro, lo agrego y digo cual era el anterior
    El anterior es el diseño completo hecho por la pagina de texas de una fuente 120V y 1A, como para guiarse con el diseño en matlab, ahora agrego el datasheet del uc384x con el calculo y explicacion paso a paso
    (detalle falta el calculo del nucleo)
2018-10-17 Continuacion calculos fuente guiando con PDF de texas y publico PDF con los resultados
    llega hasta la respuesta en frecuencia de la etapa de potencia. ahora seguiria la realimentacion.
    el PDF publicado no llega hasta lo de matlab, es de la version anterior de los scripts
2018-10-18 Modificacion de scripts poco significativas
    modificacion parametros de diseño, salidas de texto y optimizacion del script
2018-10-18 Agrego documento del calculo completo pero revision mas nueva y calculo fuente de script que usariamos
    agrego el pdf del scrip con la fuente que usariamos 100v 1.2A, mas un calculo del simulador de texas con los mismos valores para comparacion.
    el pdf del datasheet es la nueva revision, tiene corregido el tema de lm y lp pero los calculos son distintos creo, hbria que leerlo bien
2018-10-19 Agrego libros, datasheets de MOSFET, paginas utiles y modificacion del calculo fuente con posifle mosfet a utilizar
    Agrego datasheets de mosfet posibles de utilizar, libro para ver calculo de transformador.
    calculo los componentes de la fuente nuevamente con el posible mosfet para usar (fqp5n60c)
    orden de archivos
2018-10-19 borro simulaciones inncecesarias
    [ADSDSA.DSN, DESIGN1.DSN, DESIGN2.DSN, DESIGN3.DSN, Design1.opj, Design2.opj, Design3.opj, Fuente_flyback.dsn]
2018-10-25 Actualizacion scripts y txt con la seleccion de componentes. simulacion parte tl y opto
    [CircuitoTL431yOPTO.ms14]
2018-10-25 Proyecto KiCad para el PCB del PWM igual que el datasheet revision E
    Esquematico completo, falta asociar las huellas
    [PWM_JOSE_v1.kicad_pcb, PWM_JOSE_v1.sch]
2018-10-29 PCB del pwm terminado
    [PWM_JOSE_v1.kicad_pcb, PWM_JOSE_v1.sch]
